VidetteMakes/ValpoFilamentRecycler09/BOM/Datasheets/BCZAMD Printer Heating Controller - Wiring.png

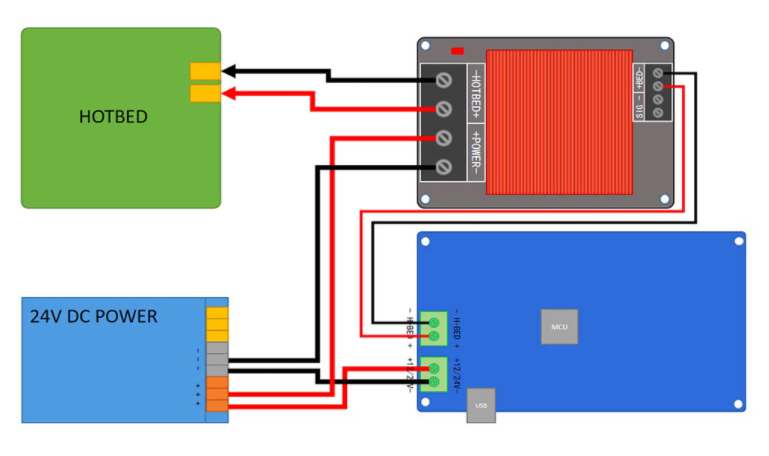
BOM/Datasheets/BCZAMD Printer Heating Controller - Wiring.png
