VidetteMakes/ValpoFilamentRecycler09/BOM/Datasheets/BCZAMD Printer Heating Controller.png

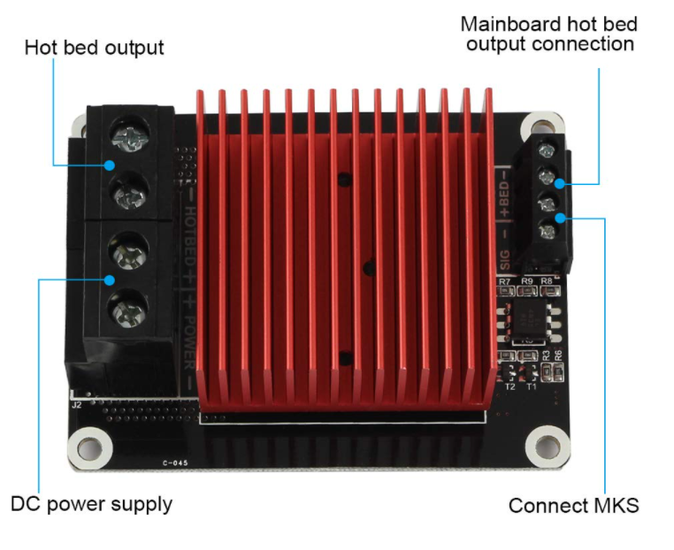
BOM/Datasheets/BCZAMD Printer Heating Controller.png
