VidetteMakes/ValpoFilamentRecycler09/README.md

# ValpoFilamentRecycler09

 Valpo Filament Senior Design Project

Check out the documentation folder for more information.
