VidetteMakes/ValpoFilamentRecycler09/PCB/Spooler Motor Driver/Spooler Motor Driver Schematic.pdf

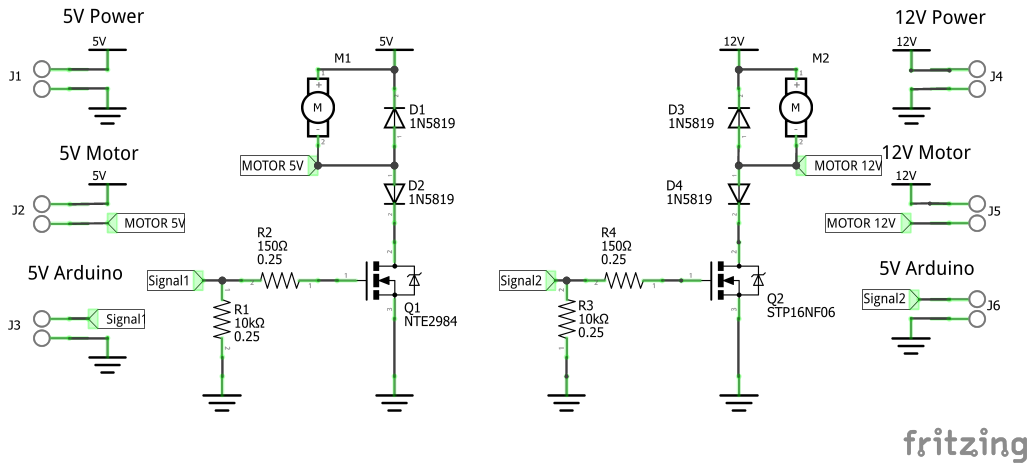
[picture p78: page 1]
