VidetteMakes/ValpoFilamentRecycler09/PCB/Spooler Motor Driver/Spooler Motor Driver.png

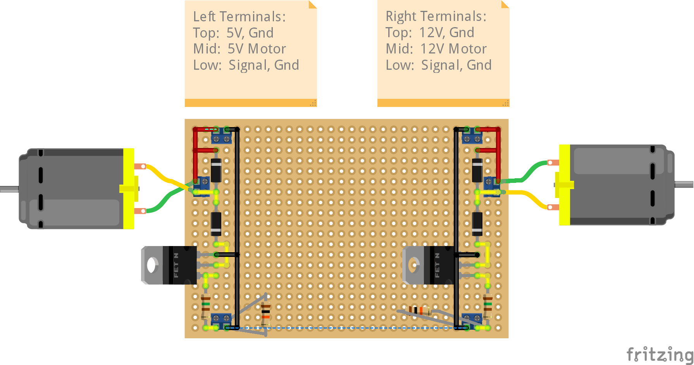
PCB/Spooler Motor Driver/Spooler Motor Driver.png
