VidetteMakes/ValpoFilamentRecycler09/BOM/BOM.xlsx

Sheet: Extruder
Part | Description | Preference | Supplier | Supplier Part Number | Manufactuer | Manufacturer Part Number | Quantity | Unit Price | Total Price
Frame | Custom welded frame and barrel holder | Sole Source |  |  | C2 Fab LLC |  | 1 |  | $0.00
Nozzle | 6061-T6511 Aluminum Square, 2.5" x 2.5" | Primary | MetalsDepot | SQ3212 | MetalsDepot |  | 1 | $5.78 | $5.78
Barrel/Screw | Precious Plastic Single Screw and Barrel | Sole Source | RobotDigg | PP-ES588L | Precious Plastics |  | 1 | $120.00 | $120.00
Barrel Flange | 304 Stainless Steel, Flat, 1/4" X 3-1/2" | Primary | MetalsDepot | F514312 | MetalsDepot |  | 1 | $5.84 | $5.84
Hopper Wall | Aluminum Plate 0.190 (3/16) thick 1' x 1' | Primary | Metals Depot | P3316 | Metals Depot |  | 1 | $29.38 | $29.38
Hopper Seal | Orange Rubber | Primary |  |  |  |  | 1 |  | $0.00
Hopper Lid | 304 Stainless Steel Wire Cloth, 3 x 3 Mesh Size, 0.27" Opening Size | Primary | Mcmaster | 85385T22 |  |  | 1 | $15.10 | $15.10
Gearbox Machine Key | Machine Key, 1018-1045 Steel, 1/4" x 1/4", 1-1/4" Long, Oversized | Primary | McMaster | 98870A405 |  |  | 1 | $8.34 | $8.34
Coupler Hub | High Torque Set Screw Flexible Shaft Coupling - Stainless Steel Hub | Primary | McMaster | 3565N1 |  |  | 1 | $48.24 | $48.24
Coupler Spider | High Torque Set Screw Flexible Shaft Coupling - Medium Split Spider | Primary | McMaster | 3565N43 |  |  | 1 | $16.18 | $16.18
Coupler Cover | 303 Stainless Steel Spider Cover for 2in Hub | Primary | McMaster | 3565N61 |  |  | 1 | $27.80 | $27.80
Insulation | Steam-Resistant High-Temperature Fiberglass Insulation, Tube, 1-1/2" Thick Wall, 1-7/8" ID, 3 Feet Long | Primary | McMaster | 5556K45 |  |  | 1 | $15.20 | $15.20
Tape | High-Strength Fiberglass Electrical Tape, Silicone Adhesive, 1/2" Wide, 54 Feet Long | Primary | McMaster | 7574A11 |  |  | 1 | $12.64 | $12.64
Barrel Heater | High-Temperature Heater for Pipes and Tubes, 120" Long with Wire Leads | Primary | McMaster | 3641K27 |  |  | 1 | $85.02 | $85.02
Nozzle Heater | Tatoko 8 x 40mm 100W Cartridge Heater 3 pieces | Primary | Amazon |  | Tatoko |  | 1 | $12.99 | $12.99
Nozzle Thermocouple | E3D Thermocouple | Primary | Amazon |  | E3D |  | 1 | $12.49 | $12.49
Electronics Enclosure | Indoor Enclosure with Hinged Cover and Knockouts, 12" x 12" x 6" | Primary | McMaster | 75065K68 | Hoffman Enclosures | AHE12X12X6 | 1 | $53.76 | $53.76
Motor | DC Permanent Magnet Motor, 1/3 Horsepower | Primary | Grainger | 48ZG52 | Leeson | 108050 | 1 | $372.00 | $372.00
Barrel Thermocouple | General purpose type K thermocouple with #6 spade terminals | Primary | Dwyer | 122095-01 | Dwyer | 122095-01 | 2 | $31.85 | $63.70
Temperature Controller | Series 16B 1/16 Din Tempearture Controller, voltage pulse and relay output, low voltage | Primary | Dwyer | 16B-23-LV | Dwyer | 16B-23-LV | 2 | $102.00 | $204.00
Solid State Relay | Solid State Relay SPST-NO 15A 75-250V | Primary | DigiKey | 255-2977-ND | Panasonic | AQA211VL | 2 | $26.12 | $52.24
Thermocouple Plug | Thermocouple Connector, Miniature Flat Pin, Type K, Plug | Primary | Automation Direct |  | ProSense | THMK-MP | 2 | $3.50 | $7.00
Thermocouple Plug | Thermocouple Connector, Miniature Flat Pin, Type K, Plug | Alternate | Newark | 30AC8456 | Omega | SMPW-K-M | 2 | $2.43
Thermocouple Receptacle | Thermocouple Connector, Miniature Flat Pin, Panel Jack, Round, Type K, Socket | Primary | Automation Direct |  | ProSense | THMK-MPJ | 2 | $6.00 | $12.00
Thermocouple Receptacle | Thermocouple Connector, Miniature Flat Pin, Panel Jack, Round, Type K, Socket | Alternate | Newark | 31AC5650 | Omega | RMJ-K-R | 2 | $2.51
Heater Receptacle | Circular Power Connector, Housing, 4 Position, Plug, Socket | Primary |  |  | TE Connectivity | 206060-1 | 2 | $7.33 | $14.66
Heater Crimp Socket | Crimp Power Contacts, Gold, 18 – 16AWG Wire Size | Primary |  |  | TE Connectivity | 66101-3 | 8 | $1.63 | $13.04
Heater Plug | Circular Power Connectors, Housing, 4 Position, Receptacle, Pin | Primary |  |  | TE Connectivity | 206061-1 | 2 | $5.73 | $11.46
Heater Crimp Pin | Crimp Power Contacts, Gold, 18 – 16AWG Wire Size, 13A Max Current | Primary |  |  | TE Connectivity | 66099-3 | 8 | $1.57 | $12.56
Motor Connector | Anderson Power Products Connector Kit, 600V, 10-12GA | Primary | Waytekwire | 37769 | Anderson Power | 5915-BK & 992G1-BK | 2 | $5.13 | $10.26
Gearbox | 881 Series Parallel Shaft Reducer, 143:1 Ratio, 12 RPM output @ 1725 RPM input | Primary |  |  | Bison Gear | 060-881-2143 | 1 | $808.75 | $808.75
24V Power Supply | AC/DC Converter, 24V, 25A | Primary | Digikey | 1866-4480-ND | Mean Well USA | SE-600-24 | 1 | $92.94 | $92.94
12V Power Supply | DC/DC Converter, 24V input, 12V, 5A output | Primary |  |  | TOBSUN | EA60-12V | 1 | $12.98 | $12.98
Motor Driver | Pololu G2 High-Power Motor Driver 18v17 | Primary | Pololu | 2991 | Pololu | 2991 | 1 | $29.95 | $29.95
Motor Driver, Resistor | 33k Ohm resistor (for Pololu Motor Driver; sets current limit) | Primary | Digikey | CF14JT33K0CT-ND | Stackpole Electronics Inc | CF14JT33K0 | 1 | $0.10 | $0.10
Motor Driver, Capacitor | Electrolytic Capacitor, 330uF, 35V, Radial (for Pololu Motor Driver) | Primary | Pololu | 882 |  |  | 1 | $0.49 | $0.49
Motor Driver, Capacitor | Electrolytic Capacitor, 470µF 50V, Radial (for Pololu Motor Driver) | Alternate | Digikey | 399-18277-1-ND | KEMET | ESK477M050AH4EA | 1 | $0.70
Motor Driver | DC Speed Control, Chassis, 0 to 48V DC Voltage Output, 20 A Max. Amps | Alternate | Grainger | 38EG41 | Dart Controls | 65E20C | 1 | $368.00
Power Connector | IEC-C14 Power Connector, Switch, Fuse | Primary | Digikey | 486-1278-ND | Schurter | DD11.0113.1111 | 1 | $11.27 | $11.27
Power Connector Fuse Drawer | IEC-C14 Fuse Drawer | Primary | Digikey | 486-2114-ND | Schurter | 4301.1409 | 1 | $4.70 | $4.70
Power Connector Fuse | 5x20 mm Fuse, 10A | Primary | Digikey | 486-1226-ND | Schurter | 34.3127 | 1 | $0.44 | $0.44
Power Cord | Power Cord, Black, IEC 320-C14 To IEC 320-C13, 6.00' (1.83m) | Primary | Digikey | 2830-PWRC13C1406FBLK-ND | Unirise USA | PWRC13C1406FBLK | 1 | $4.99 | $4.99
Power Cord | Power Cord, Black, IEC 320-C14 To IEC 320-C13, 6.00' (1.83m) | Alternate | Adafruit | 3311 |  |  | 1 | $5.95
 | Standard LCD 16x2 + extras - white on blue | Primary | DigiKey | 1528-1502-ND | Adafruit | 181 | 2 | $9.95 | $19.90
 | I2C / SPI Character LCD Backpack | Primary | DigiKey | 1528-1446-ND | Adafruit | 292 | 2 | $9.95 | $19.90
 |  |  |  | Total |  |  |  |  | $2248.09
 | REMOVE
 | Emergency Stop Enclosed Push-Button Switch |  | McMaster | 6785K21 |  |  | 1 | 43.8
 | Emergency Stop Button |  | Digikey | 360-FF0126BBCAEA01-ND |  |  | 1 | 43.82
 | DC/DC Converter, 24V input, 5V,1.2A output |  | Digikey | 102-4574-ND | CUI Inc | PQDE6W-Q24-S5-T | 1 | 20.25
 | REPLACE HARDWIRED CORD WITH C20
 | Power Cord, 12AWG, NEMA 5-20P, 6.56 foot |  | Digikey | 1939-1017-ND | GlobTek Inc | 3201776F6000(R) | 1 | 19.54
 | EVALUATE AS ALTERNATE:
 | Helical Gearbox, 40:1 Ratio, 44 RPM output @ 1750 RPM input |  | Automation Direct | HGR-37-040-A | Iron Horse | HGR-37-040-A | 1 | 410
 | CONSIDER (IF REVERSING SWITCH IS NEEDED):
 | 07-2-2-17 KISSLING Series 07, Toggle Switches, Double Pole - Double Throw Configuration (Pole-Throw), M12 x .75, Sealed Toggle Switch, Cu, Silver Tin Oxide |  |  |  | TE Connectivity | K1002983 | 1 | 19.32
 | Rocker Switch, Non Illuminated, SPDT, (On)-Off-On, Black, Panel Mount, 15 A |  | Newark | 97W6256 | Eaton | NGR10061BG00N | 1 | 14.65

Sheet: Spooler
Part | Description | Preference | Supplier | Supplier Part Number | Manufactuer | Manufacturer Part Number | Quantity | Unit Price | Total Price
Frame | T-Slotted Framing Rails, Silver, 4-1/2" High x 1-1/2" Wide, Solid | Primary | McMaster | 47065T521 | McMaster |  | 1 | $96.10 | $96.10
Fan | Fan Blower 5VDC, 45mm L x 45mm H, 3.5 CFM (0.098m³/min), 3 Wire Leads |  | Digikey | 603-2120-ND | Delta Electronics | BFB04505HHA-CF00 | 2 | 13.27 | 26.54
Diameter Sensor | Digital Indicator 0-0.5"/12.7mm Resolution 0.00005" |  | Amazon |  | Clockwise Tools | DITR-0055 | 1 | $44.45 | $44.45
Bearing | 6mm Bore Bearing with 19mm White Plastic Square Tire 6x19x6mm |  | Amazon | WT0619 | VXB | 6MMX19MMTIRE-WHITE | 2 | $8.09 | $16.18
USB Cable | USB 2.0 Cable, A Male to Micro B Male, Shielded, 6.56' (2.00m) |  | DigiKey | AE10342-ND | Assmann WSW Components | AK67421-2 | 1 | $5.04 | $5.04
Photo Interrupter | T-Slot Photo Interrupter with 1 Meter Cable |  |  |  | Adafruit | 3985 | 1 | $3.95 | $3.95
Load Cell | Strain Gauge Load Cell, 4 Wires, 1Kg |  | Digikey | 1528-4540-ND | Adafruit | 4540 | 4 | $3.95 | $15.80
Spooler Motor | 942DLN Series Gearbox & DC Motor, 12V |  |  |  | MFA Como Drills | 942DLN | 1
MOSFET, Fans | N-Channel Power MOSFET, 60V, 17A, Through Hole, TO-220 (for 5V DC motors) |  | DigiKey | 2368-NTE2984-ND | NTE Electronics | NTE2984 | 7 | $2.75 | $19.25
MOSFET, Spooler | N-Channel Power MOSFET, 60V, 16A, Through Hole, TO-220 (for 12V DC motors) |  | Digikey | 497-2766-5-ND | ST | STP16NF06 |  |  | $0.00
Arduino Uno | Arduino Uno R3 |  | Digikey | 1050-1024-ND | Arduino | A000066 | 1 | $22.00 | $22.00
USB-A Connector | USB-A Connector, Through Hole, Right Angle |  | DigiKey | ED2989-ND | On Shore Technology | USB-A1HSW6 | 1 | $0.48 | $0.48
Headers, Male | Connector Header, Through Hole, Vertical, 0.100" (2.54mm), 40 position |  | DigiKey | S1012EC-40-ND | Sullins Connector Solutions | PREC040SAAN-RC | 5 | $0.51 | $2.55
Connector, 2 position | Connector Header, Through Hole, Vertical, 0.098" (2.50mm), 2 position |  | DigiKey | 455-2247-ND | JST Sales America | B2B-XH-A(LF)(SN) | 7 | $0.15 | $1.05
Plug, 2 position | Connector Housing, Free Hanging, 0.098" (2.50mm), 2 position |  | DigiKey | 455-2266-ND | JST Sales America | XHP-2 | 7 | $0.10 | $0.70
Connector, 3 position | Connector Header, Through Hole, 0.098" (2.50mm), 3 position |  | DigiKey | 455-2248-ND | JST Sales America | B3B-XH-A(LF)(SN) | 4 | $0.19 | $0.76
Plug, 3 position | Connector Housing, Free Hanging, 0.098" (2.50mm), 3 position |  | DigiKey | 455-2219-ND | JST Sales America | XHP-3 | 4 | $0.10 | $0.40
Connector, 4 position | Connector Header, Through Hole, 0.098" (2.50mm), 4 position |  | DigiKey | 455-2249-ND | JST Sales America | B4B-XH-A(LF)(SN) | 4 | $0.21 | $0.84
Plug, 4 position | Connector Housing, Free Hanging, 0.098" (2.50mm), 4 position |  | DigiKey | 455-2267-ND | JST Sales America | XHP-4 | 4 | $0.10 | $0.40
Connector, 5 position | Connector Header, Through Hole, 0.098" (2.50mm), 5 position |  | DigiKey | 455-2270-ND | JST Sales America | B5B-XH-A(LF)(SN) | 2 | $0.25 | $0.50
Plug, 6 position | Connector Housing, Free Hanging, 0.098" (2.50mm), 6 position |  | DigiKey | 455-2218-ND | JST Sales America | XHP-6 | 2 | $0.14 | $0.28
Wire | TUOFENG 22AWG PVC Electrical Wire Kit |  | Amazon |  | Tuofeng |  | 1 | 14.99 | $14.99
Power Supply | DC Power Wall Wort, 12V, 2A |  |  |  |  |  | 1 |  | $0.00
 |  |  |  | Total |  |  |  |  | $272.26
 | REPLACE 5V FAN WITH 12V FAN?
OBSOLETE: | Fan Blower 12VDC Square/Rounded - 60mm L x 60mm H Vapo-Bearing™ 5.7 CFM (0.160m³/min) 2 Wire Leads |  | Digikey | 259-1752-ND | Sunon Fans | MF60151V1-B00U-A99 | 2 | 6.97
 | EVALUATE AS ALTERNATE:
 | Compression Load Cell |  | Digikey | 223-FX292X-100A-0010-L-ND | TE Connectivity Measurement Specialties | FX292X-100A-0010-L | 3 | 22.51
 | Arduino MKR 485 Shield |  |  |  | Arduino | ASX00004 | 1 | 32.1
 | Brushed DC Motor Gearmotor 100 RPM 8W 24VDC (can run at 12V, but recommend 12V; see similar by same manufacturer) |  | Digikey | 2183-4685-ND | Pololu | 4685 | 1 | 24.95
 | ORIGINALLY PART OF TENSIONER; OBSOLETE
 | Continuous Rotation DC Motor Servo motor, RC Hobby, 4.8 - 6VDC |  | Digikey | 2589-33485S-ND | Hitec | 33485S | 2 | 17.39
 | EXTRA PARTS
 | Linear Optical Array Sensor I2C, SPI Output |  | Digikey | MLX75306KXZ-BAA-000-RETR-ND | Melexis Technologies NV | MLX75306KXZ-BAA-000-RE | 1 | 13.88
 | Screw Terminal Block, Side-Mounted, Gray ABS Plastic, 4 Circuits |  | McMaster | 1041N9 |  |  | 1 | 13.77

Sheet: Controller
Part | Description | Preference | Supplier | Supplier Part Number | Manufactuer | Manufacturer Part Number | Quantity | Unit Price | Total Price
 | Standard LCD 16x2 + extras - white on blue | Primary | DigiKey | 1528-1502-ND | Adafruit | 181 | 2 | $9.95 | $19.90
 | I2C / SPI Character LCD Backpack | Primary | DigiKey | 1528-1446-ND | Adafruit | 292 | 2 | $9.95 | $19.90
 | Pushbutton, SPST, Normally Open, 0.1A, 32V |  | Digikey | 401-1973-ND | C&K | D6R10 F1 LFS | 5 | $1.13 | $5.65
 | Potentiometer, 5k Ohm, Through Hole, 0.05W |  | DigiKey | 987-1294-ND | TT Electronics | P120PK-F17BR5K | 4 | $0.63 | $2.52
 | SparkFun Transceiver Breakout - RS-485 | Primary |  |  | SparkFun | BOB-10124 | 1 | $10.95 | $10.95
DC/DC Converter | Linear Regulator DC DC Converter, 8V - 28V Input, 5V, 1A Output | Primary | DigiKey | 945-2201-ND | Recom Power | R-78E5.0-1.0 | 1 | $2.52 | $2.52
Total |  |  |  |  |  |  |  |  | $61.44
 | NOT PRESENT:
 | Potentiometer, 10k Ohm Logarithmic, Panel Mount, 0.1W, Solder Lug |  | Digikey | 987-P165K200PNN20MN103-ND | TT Electronics/BI | P165K200PNN20MN103 | 1 | 4.13
 | Digital Potentiometer, 10k Ohm, 100 Taps, 8-PDIP |  | DigiKey | DS1804-010+-ND | Maxim Integreated | DS1804-010+ | 1 | 4.3
 | REMOVE:
 | Arduino Mega 2560 |  | Digikey | 1050-1018-ND | Arduino | A000067 | 1 | 38.5
 | SparkFun Logic Level Converter - Bi-Directional |  |  |  | SparkFun | BOB-12009 | 1 | 2.95
 | RJ45 (Ethernet) Jack, Right Angle, Shielded |  | DigiKey | AE10387-ND | Assmann WSW Components | A-2004-2-4-LPS-N-R | 2 | 1.2
 | RJ45 (Ethernet) Cable, Unshielded, 3.00' (914.4mm) |  | DigiKey | 367-1104-ND | Cinch Connectivity Solutions | 73-7791-3 | 1 | 2.56
