VidetteMakes/ValpoFilamentRecycler09/CAD/Coupler/couplerassembly.SLDASM

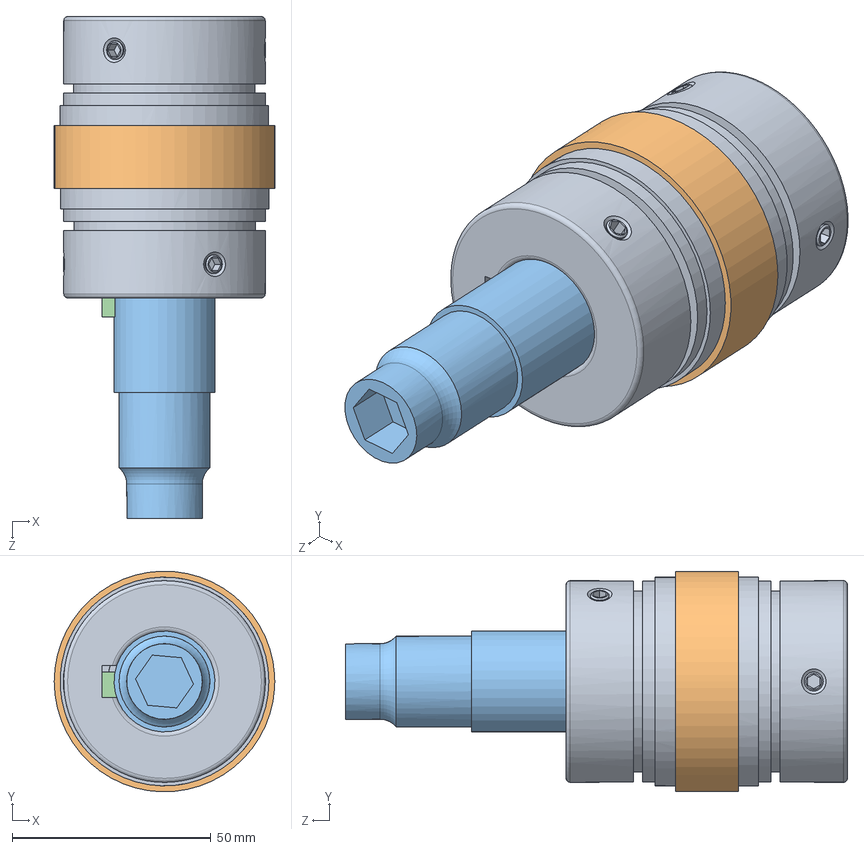
[picture p80: CAD file, 2021-05-10]
CAD/Coupler/couplerassembly.SLDASM
55.6 x 55.5 x 126.4 mm
CouplerPiece x 2
CouplerConnection
CouplerShaft
98870A405_STEEL MACHINE KEY
