VidetteMakes/ValpoFilamentRecycler09/CAD/Final AssemblyF.SLDASM

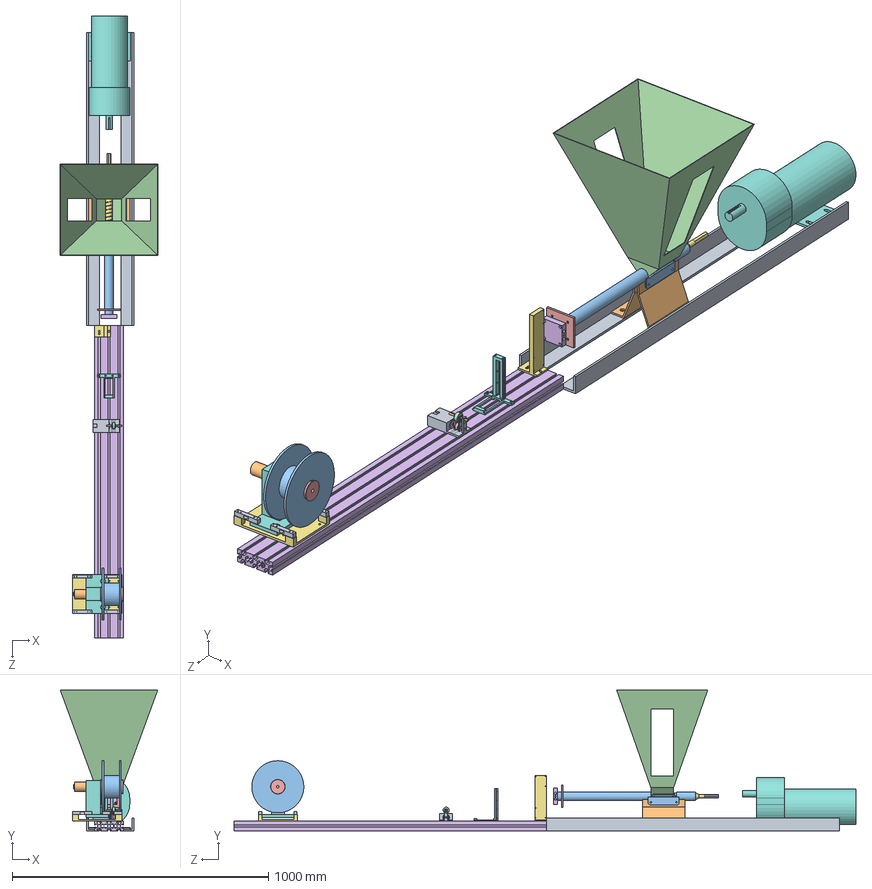
[picture p81: CAD file, 2021-05-10]
CAD/Final AssemblyF.SLDASM
381.0 x 550.1 x 2427.0 mm
Angle IronsF
Mounting x 2
Barrel1.3
Hopper
flange
nozzle cap
Screw
DCMotor
Roller Structure5
Axle4
Roller_AxelF
Roller3
RollerF
ServoF
BaseMountingPlateSpooler
TopPlateSpooler
StrainGauge x 4
Spooler servo
1kg_Spool
SpoolCrusher
SpoolCrusherEnd
Mounting body
Fan mount 2.0
SlackSensorGrande
