VidetteMakes/ValpoFilamentRecycler09/CAD/Extrusion Assembly/Extrusion Assembly.SLDASM

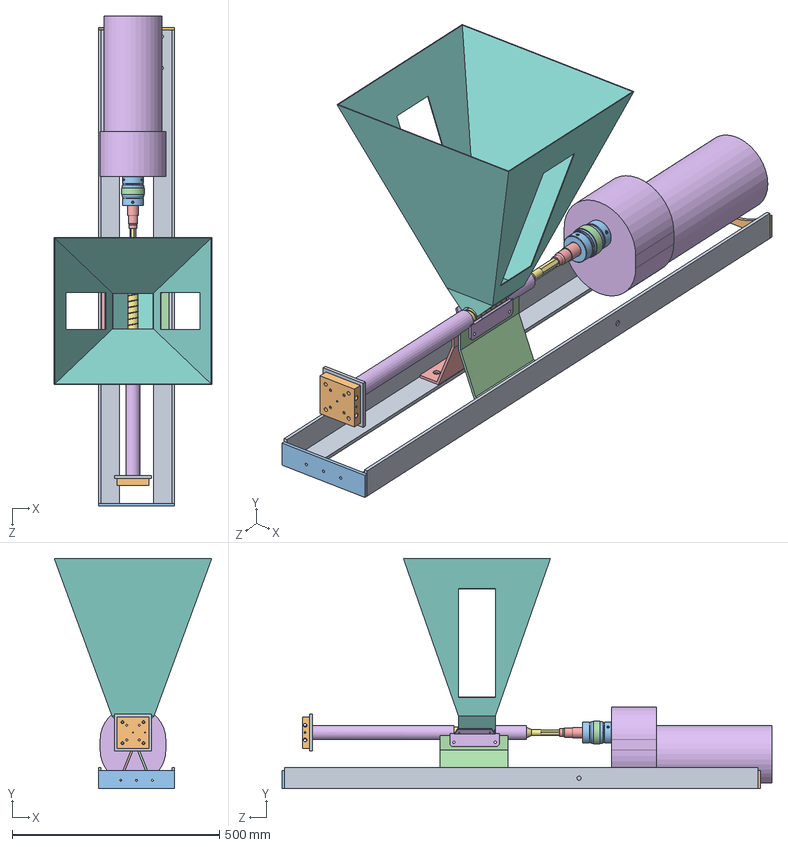
[picture p82: CAD file, 2021-05-10]
CAD/Extrusion Assembly/Extrusion Assembly.SLDASM
381.0 x 556.4 x 1183.4 mm
Angle IronsF
Back_plate
Front Plate
Mounting (1)
Mounting
Barrel1.3
Screw
Hopper
flange
Nozzle_3mm (1)
CouplerPiece x 2
CouplerConnection
CouplerShaft
DCMotor
