VidetteMakes/ValpoFilamentRecycler09/CAD/PCB Boxes/UI_BOX_ASSEM.SLDASM

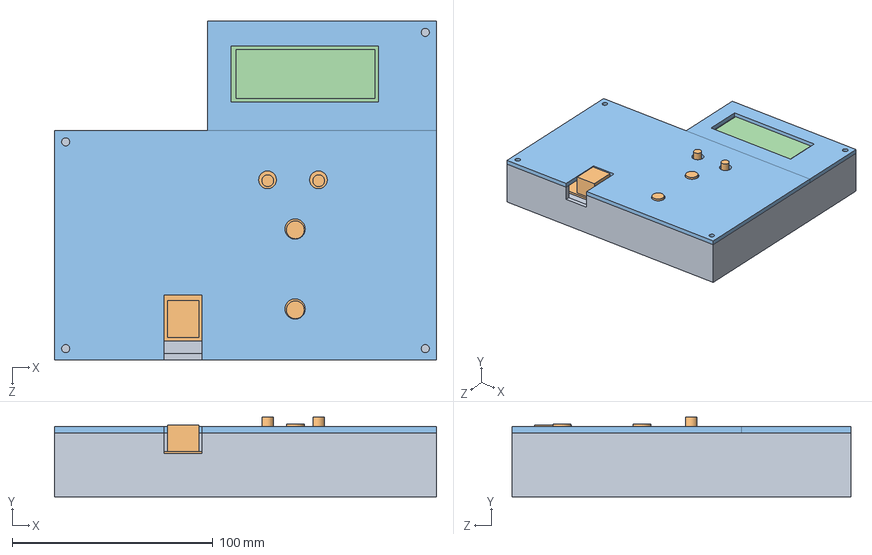
[picture p83: CAD file, 2021-05-10]
CAD/PCB Boxes/UI_BOX_ASSEM.SLDASM
190.5 x 39.7 x 168.9 mm
UI_Box
UI_PCB
UI_Box_Top
LCD
