VidetteMakes/ValpoFilamentRecycler09/CAD/Tensioner/Tensioner Assembly.SLDASM

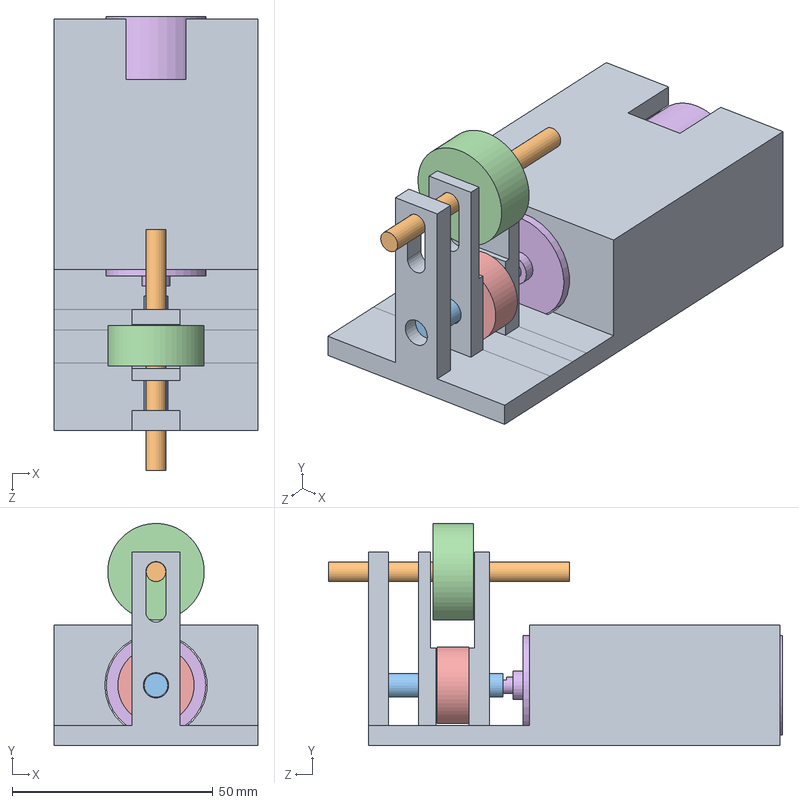
[picture p84: CAD file, 2021-05-10]
CAD/Tensioner/Tensioner Assembly.SLDASM
50.8 x 55.3 x 113.1 mm
Roller Structure5
Axle4
Roller_AxelF
Roller3
RollerF
ServoF
