VidetteMakes/ValpoFilamentRecycler09/CAD/Spooler/SpoolerAssem.SLDASM

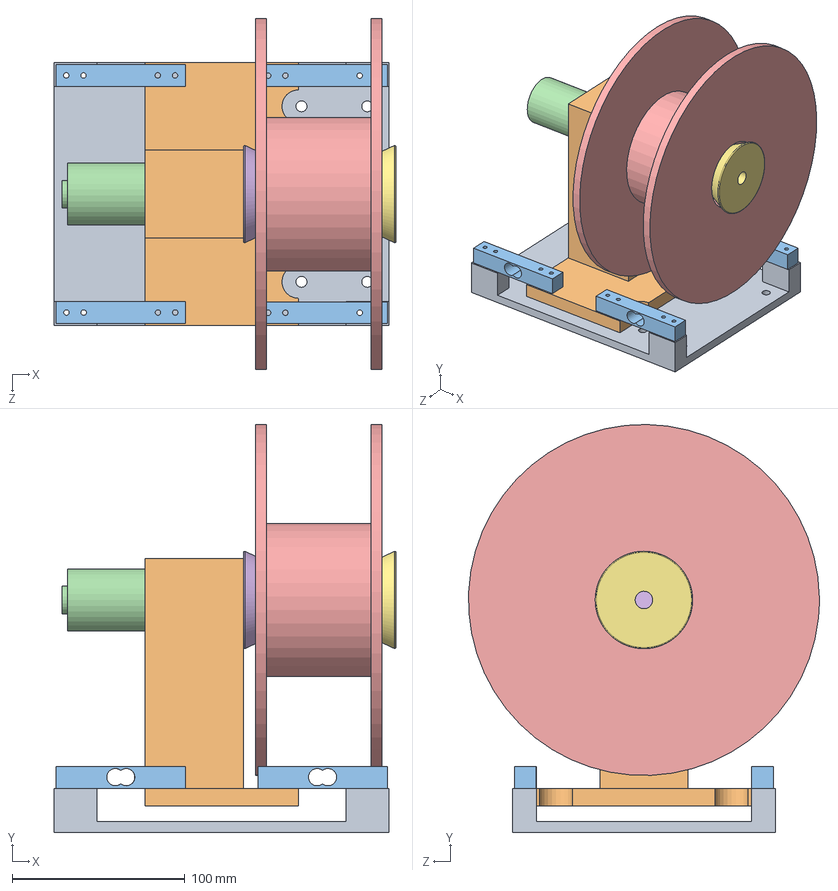
[picture p85: CAD file, 2021-05-10]
CAD/Spooler/SpoolerAssem.SLDASM
198.0 x 236.2 x 203.1 mm
BaseMountingPlateSpooler
TopPlateSpooler
StrainGauge x 4
Spooler servo
1kg_Spool
SpoolCrusher
SpoolCrusherEnd
