VidetteMakes/ValpoFilamentRecycler09/CAD/Extrusion Assembly/Base.SLDASM

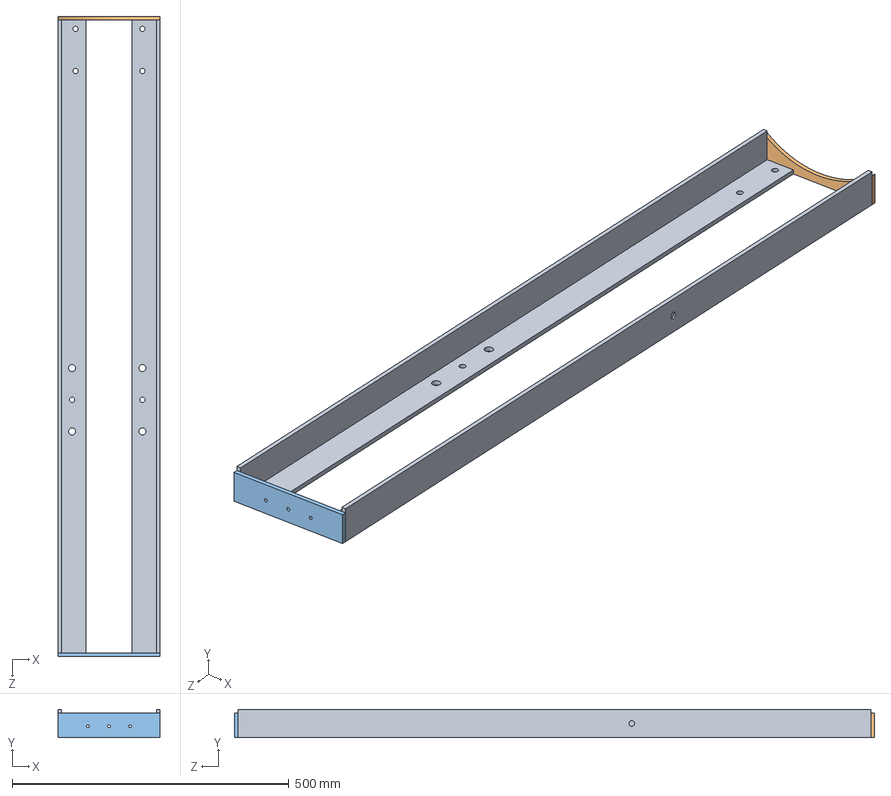
[picture p86: CAD file, 2021-05-10]
CAD/Extrusion Assembly/Base.SLDASM
184.1 x 50.8 x 1155.7 mm
Angle IronsF
Back_plate
Front Plate
