VidetteMakes/ValpoFilamentRecycler09/CAD/Extrusion Assembly/Barrel_Assembly.SLDASM

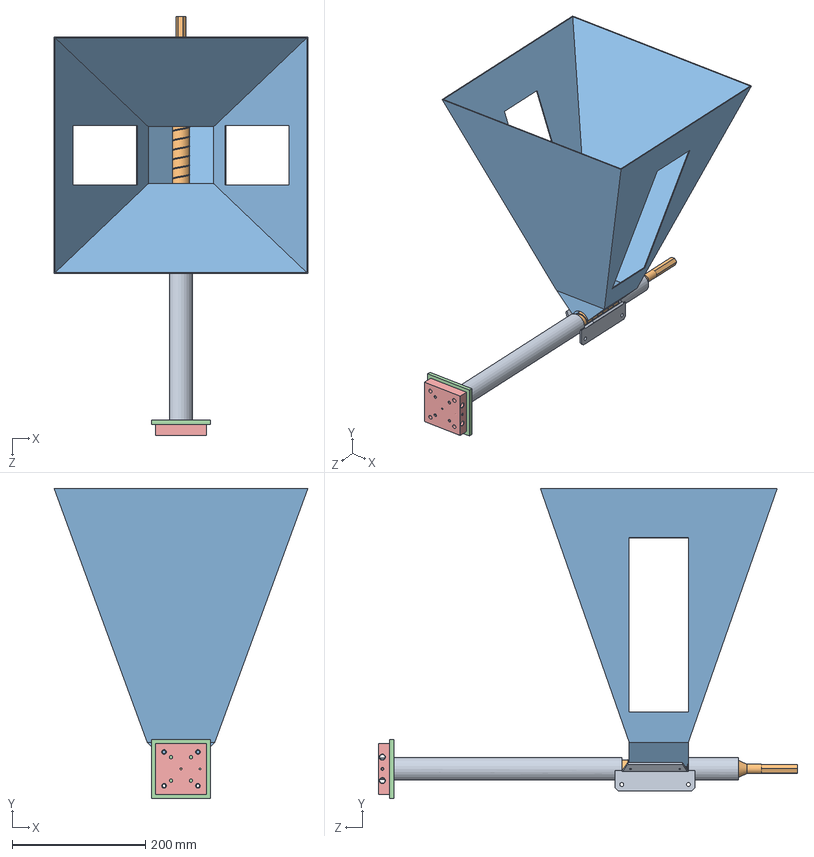
[picture p87: CAD file, 2021-05-10]
CAD/Extrusion Assembly/Barrel_Assembly.SLDASM
381.0 x 465.3 x 629.2 mm
Barrel1.3
Screw
Hopper
flange
Nozzle_3mm (1)
