VidetteMakes/ValpoFilamentRecycler09/CAD/.STL files/Tensioner_Platform.STL

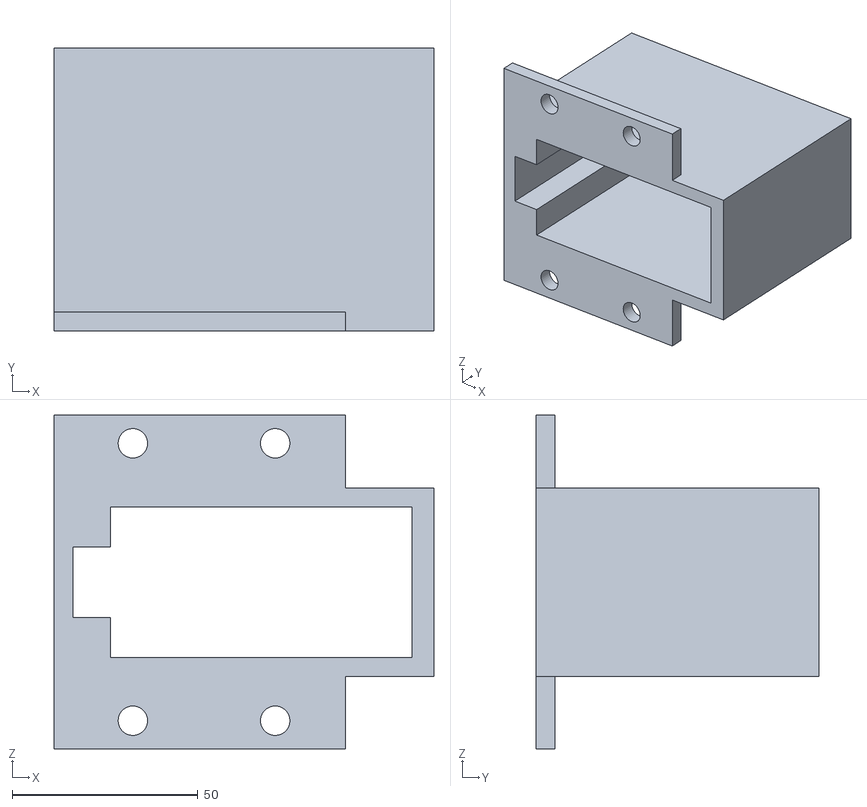
[picture p88: CAD file, 2021-05-10]
CAD/.STL files/Tensioner_Platform.STL
102.4 x 76.2 x 90.0
