VidetteMakes/ValpoFilamentRecycler09/CAD/Coupler/CouplerPiece.SLDPRT

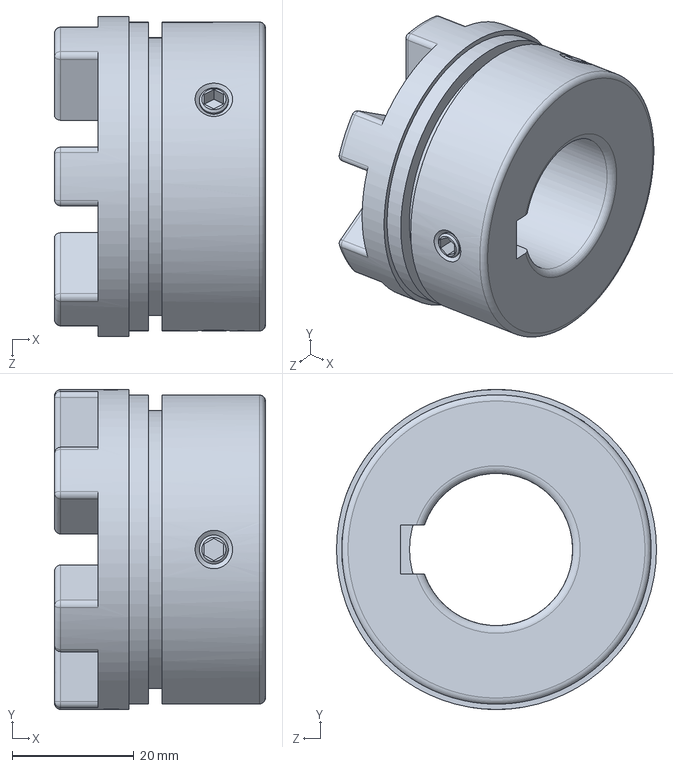
[picture p89: CAD file, 2021-05-10]
CAD/Coupler/CouplerPiece.SLDPRT
34.7 x 52.6 x 52.6 mm
