VidetteMakes/ValpoFilamentRecycler09/CAD/Dial Indicator Housing/FilamentMeasBackPlateV2.stp

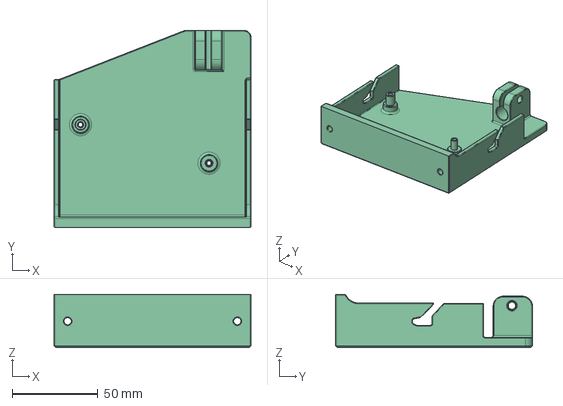
[picture p90: CAD file, 2021-07-17]
CAD/Dial Indicator Housing/FilamentMeasBackPlateV2.stp
115.0 x 115.0 x 31.0 mm
