VidetteMakes/ValpoFilamentRecycler09/CAD/Extrusion Assembly/CouplerConnection.SLDPRT

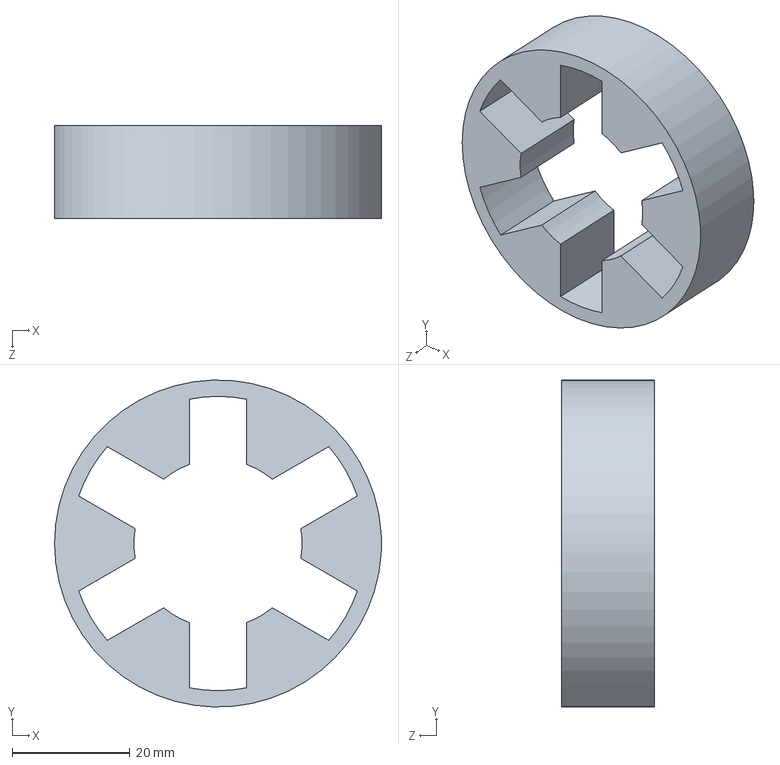
[picture p91: CAD file, 2021-05-10]
CAD/Extrusion Assembly/CouplerConnection.SLDPRT
55.6 x 55.5 x 15.9 mm
