VidetteMakes/ValpoFilamentRecycler09/CAD/Main components/DCMotor.SLDPRT

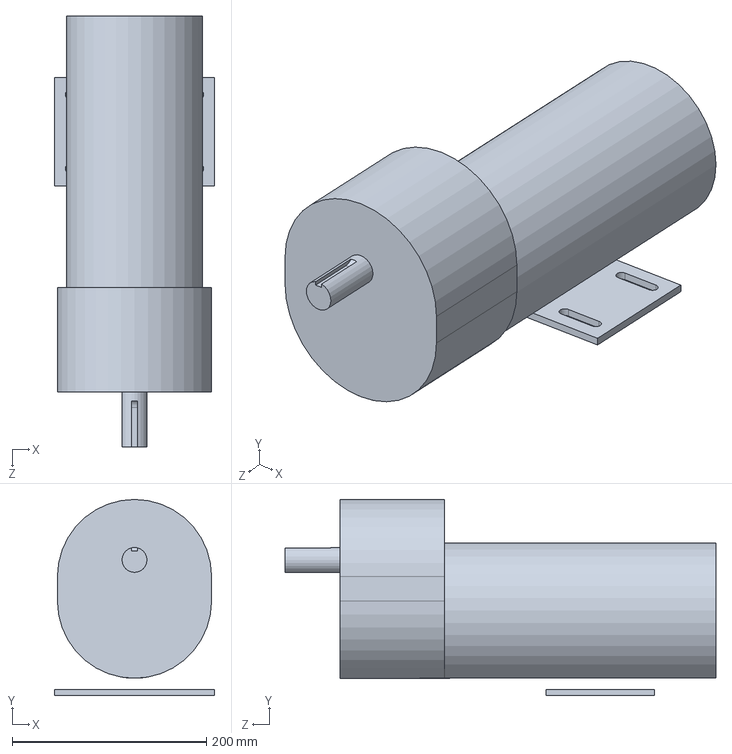
[picture p92: CAD file, 2021-05-10]
CAD/Main components/DCMotor.SLDPRT
165.1 x 202.0 x 443.8 mm
