VidetteMakes/ValpoFilamentRecycler09/CAD/PCB Boxes/UI_Box.SLDPRT

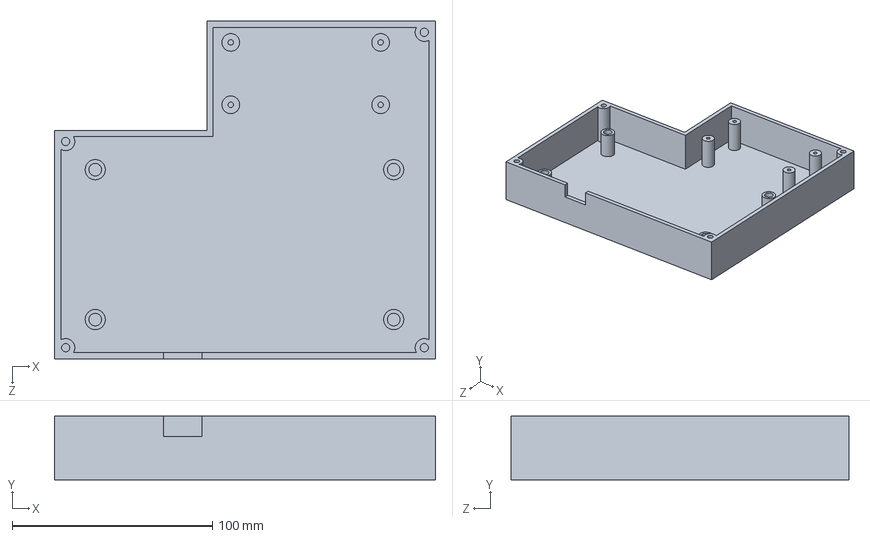
[picture p93: CAD file, 2021-05-10]
CAD/PCB Boxes/UI_Box.SLDPRT
190.5 x 31.8 x 168.9 mm
