VidetteMakes/ValpoFilamentRecycler09/CAD/ServoCap.SLDPRT

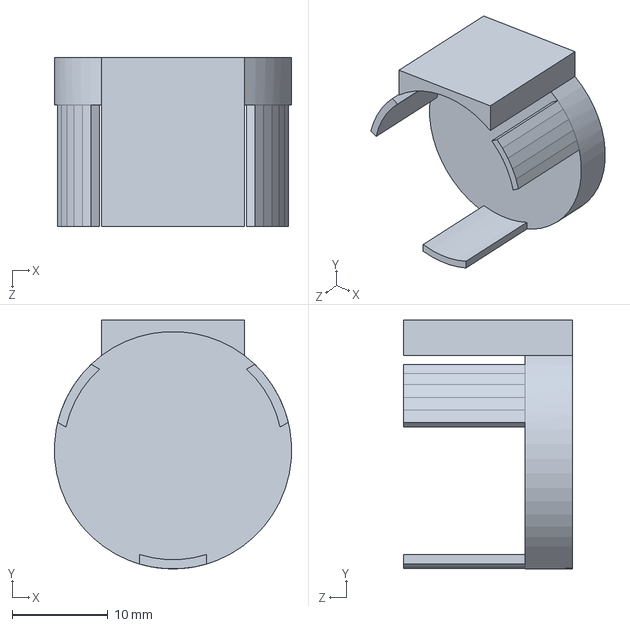
[picture p94: CAD file, 2021-05-10]
CAD/ServoCap.SLDPRT
24.8 x 26.0 x 17.7 mm
