VidetteMakes/ValpoFilamentRecycler09/CAD/Spooler/SpoolCrusher.SLDPRT

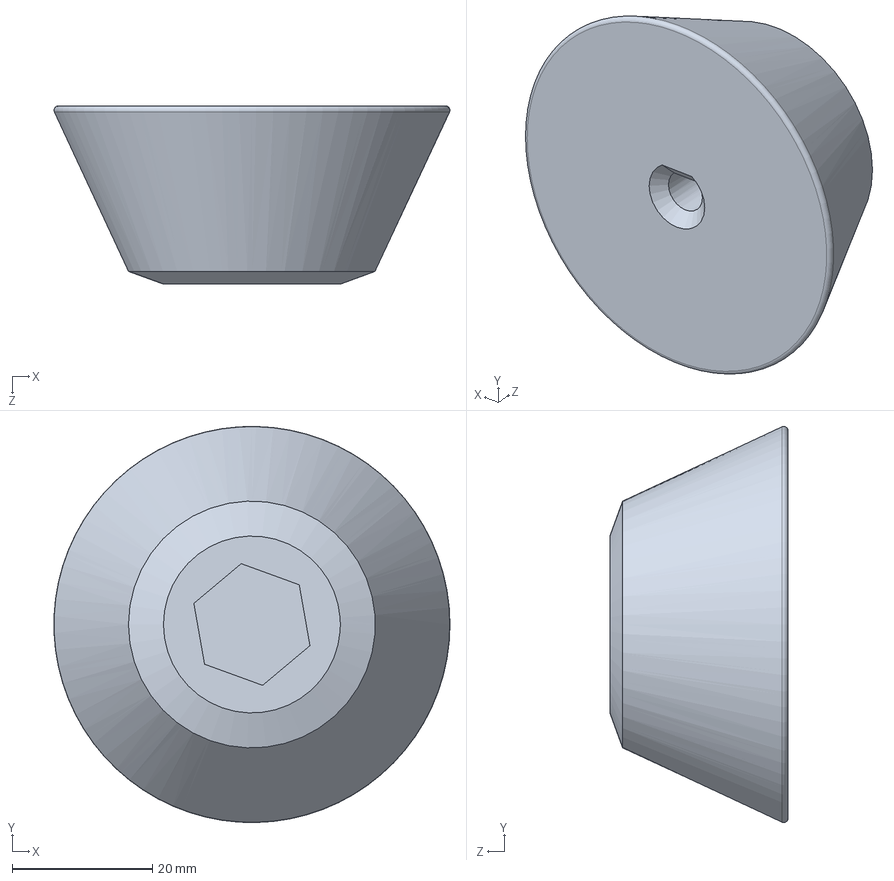
[picture p95: CAD file, 2021-05-10]
CAD/Spooler/SpoolCrusher.SLDPRT
56.4 x 56.4 x 25.4 mm
