VidetteMakes/ValpoFilamentRecycler09/CAD/Tensioner/Axle4.SLDPRT

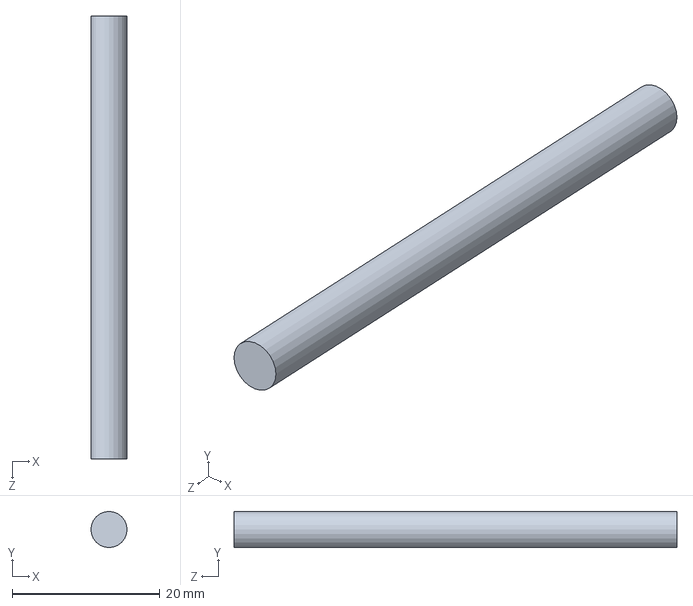
[picture p96: CAD file, 2021-05-10]
CAD/Tensioner/Axle4.SLDPRT
4.90 x 4.90 x 60.0 mm
