VidetteMakes/ValpoFilamentRecycler09/CAD/Triangular Mounting/Mounting.SLDPRT

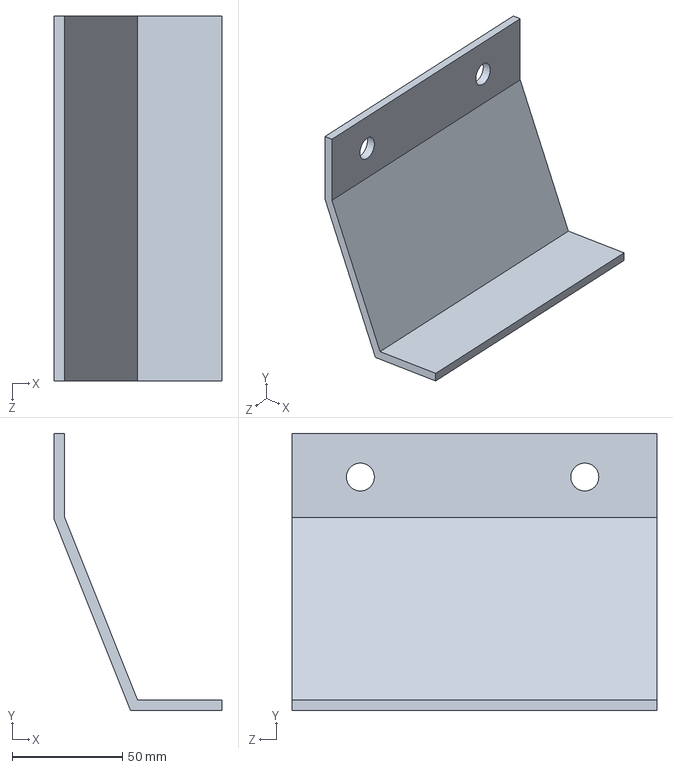
[picture p97: CAD file, 2021-05-10]
CAD/Triangular Mounting/Mounting.SLDPRT
75.9 x 125.4 x 165.1 mm
