VidetteMakes/ValpoFilamentRecycler09/CAD/.STL files/Fan mount 2.0 (1).STL

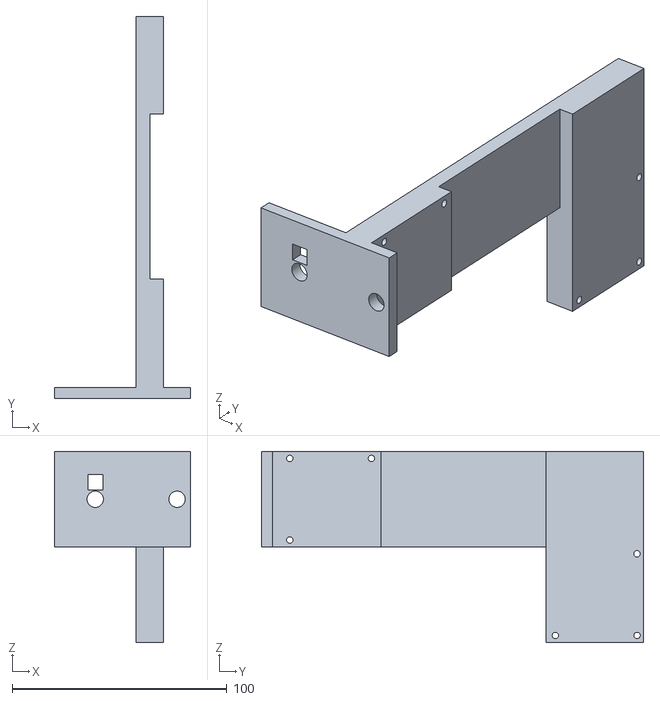
[picture p98: CAD file, 2021-05-10]
CAD/.STL files/Fan mount 2.0 (1).STL
63.5 x 177.8 x 88.9
