VidetteMakes/ValpoFilamentRecycler09/CAD/Dial Indicator Housing/FilamentMeasurementArrmOuterV3.stp

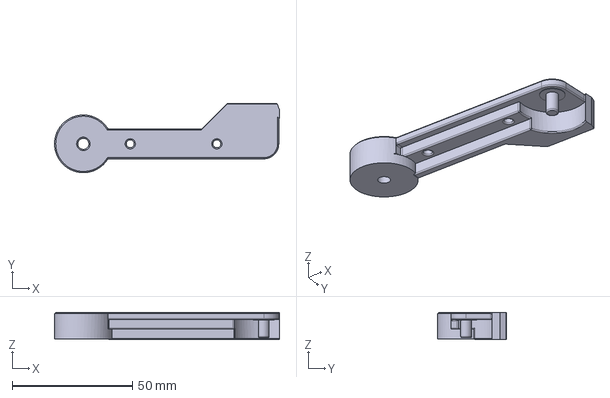
[picture p99: CAD file, 2021-07-17]
CAD/Dial Indicator Housing/FilamentMeasurementArrmOuterV3.stp
93.5 x 28.9 x 11.2 mm
