VidetteMakes/ValpoFilamentRecycler09/CAD/Extrusion Assembly/Barrel1.3.SLDPRT

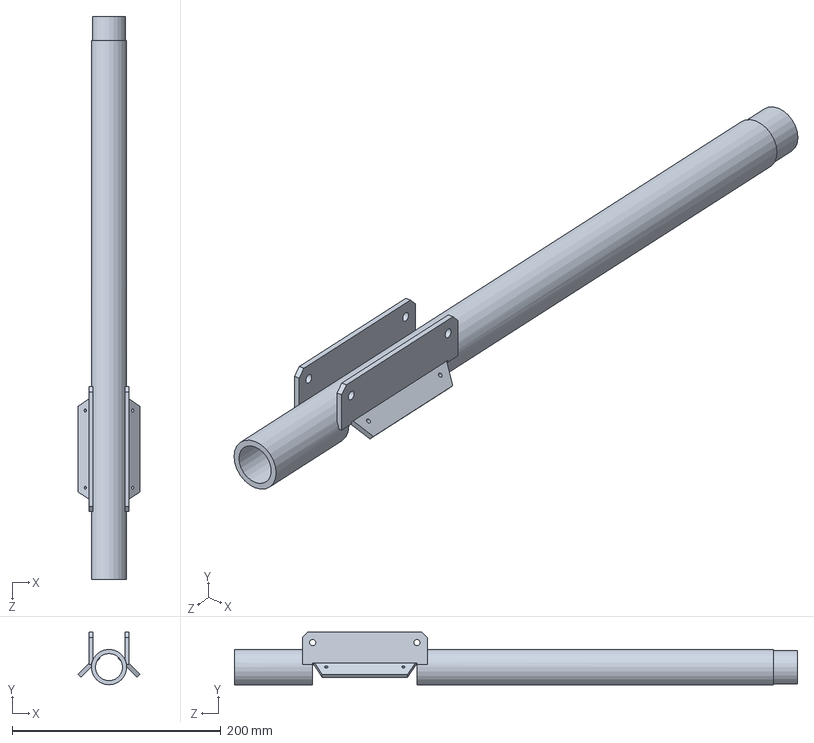
[picture p100: CAD file, 2021-05-10]
CAD/Extrusion Assembly/Barrel1.3.SLDPRT
59.6 x 50.5 x 540.0 mm
