VidetteMakes/ValpoFilamentRecycler09/CAD/PCB Boxes/Controller_lid.SLDPRT

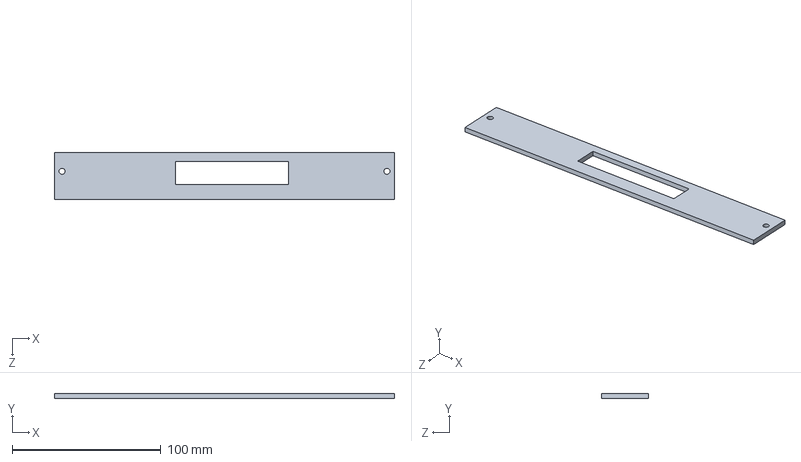
[picture p101: CAD file, 2021-05-10]
CAD/PCB Boxes/Controller_lid.SLDPRT
228.6 x 3.17 x 31.8 mm
