VidetteMakes/ValpoFilamentRecycler09/CAD/Spooler/1kg_Spool.SLDPRT

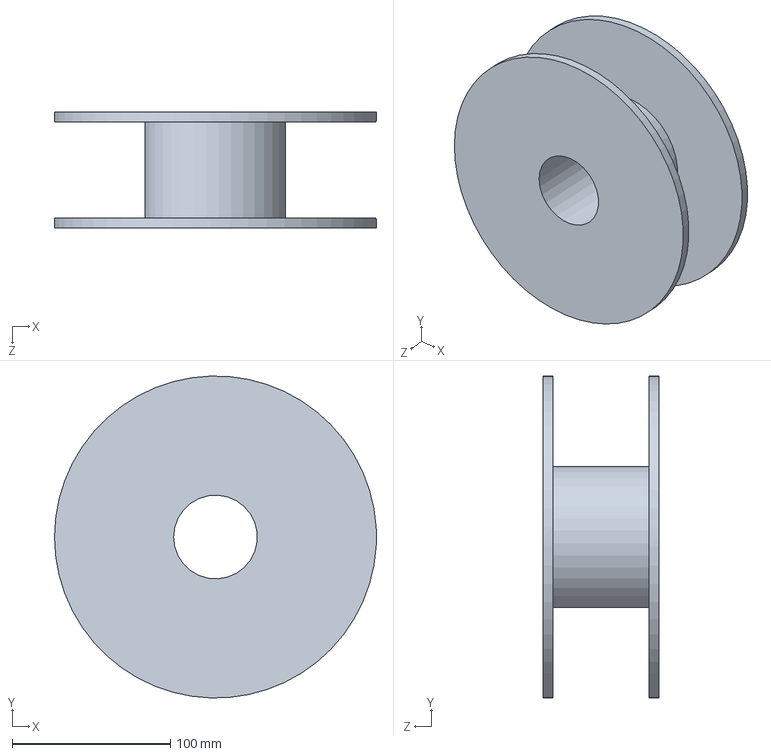
[picture p102: CAD file, 2021-05-10]
CAD/Spooler/1kg_Spool.SLDPRT
203.2 x 203.1 x 73.2 mm
