VidetteMakes/ValpoFilamentRecycler09/CAD/Tensioner/Roller Structure5.SLDPRT

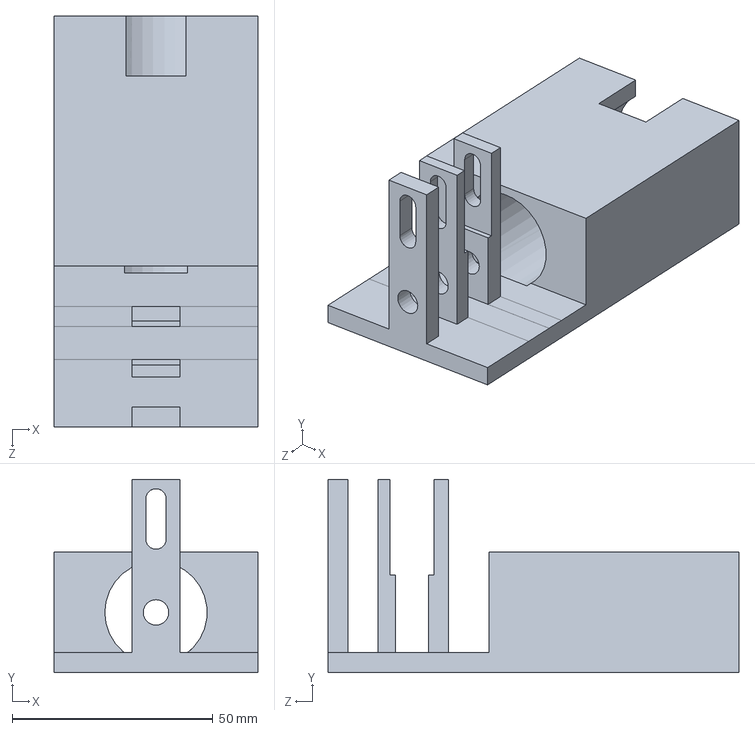
[picture p103: CAD file, 2021-05-10]
CAD/Tensioner/Roller Structure5.SLDPRT
50.8 x 48.1 x 102.4 mm
