VidetteMakes/ValpoFilamentRecycler09/CAD/Troubled components/nikki mods/RollerF.SLDPRT

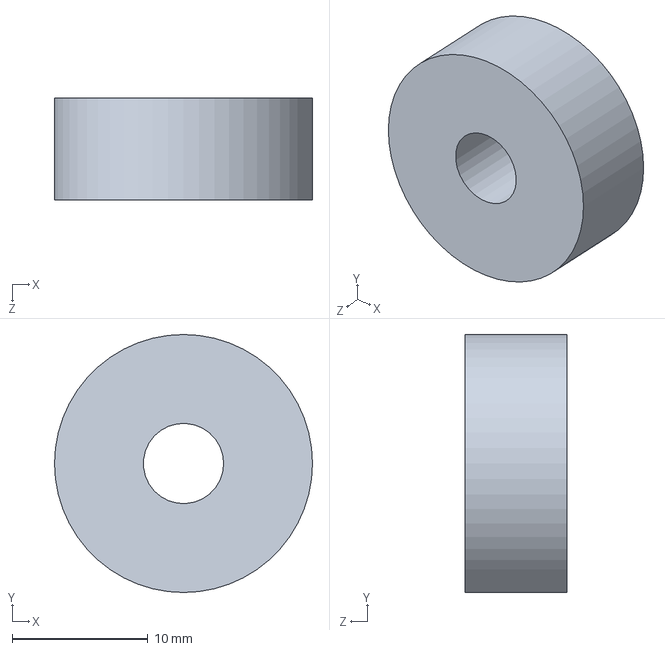
[picture p104: CAD file, 2021-05-10]
CAD/Troubled components/nikki mods/RollerF.SLDPRT
19.0 x 19.0 x 7.50 mm
