VidetteMakes/ValpoFilamentRecycler09/CAD/.STL files/SlackSensorGrande.STL

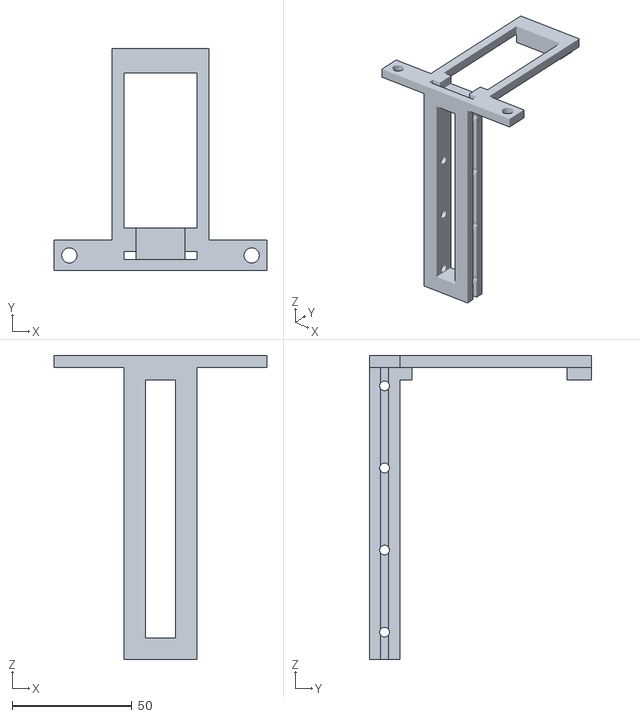
[picture p105: CAD file, 2021-05-10]
CAD/.STL files/SlackSensorGrande.STL
88.9 x 92.9 x 127.0
