VidetteMakes/ValpoFilamentRecycler09/CAD/Coupler/CouplerShaft.SLDPRT

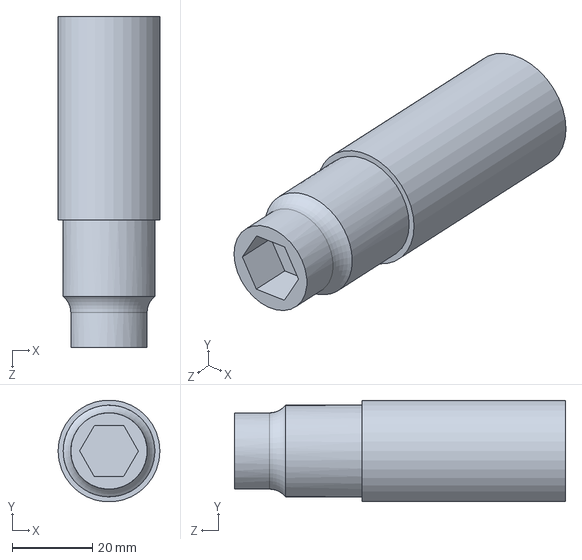
[picture p106: CAD file, 2021-05-10]
CAD/Coupler/CouplerShaft.SLDPRT
25.4 x 25.3 x 82.5 mm
