VidetteMakes/ValpoFilamentRecycler09/CAD/FilimentSupportBracket.SLDPRT

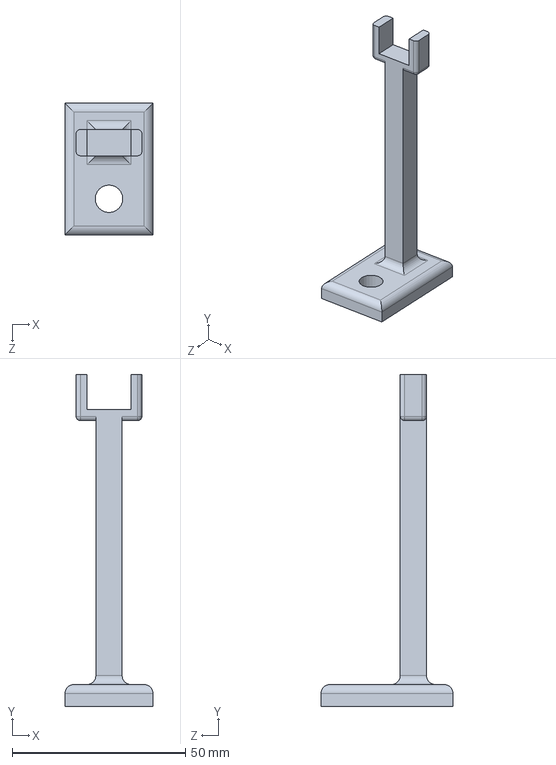
[picture p107: CAD file, 2021-05-10]
CAD/FilimentSupportBracket.SLDPRT
25.4 x 95.9 x 38.1 mm
