VidetteMakes/ValpoFilamentRecycler09/CAD/PCB Boxes/Controller_box.SLDPRT

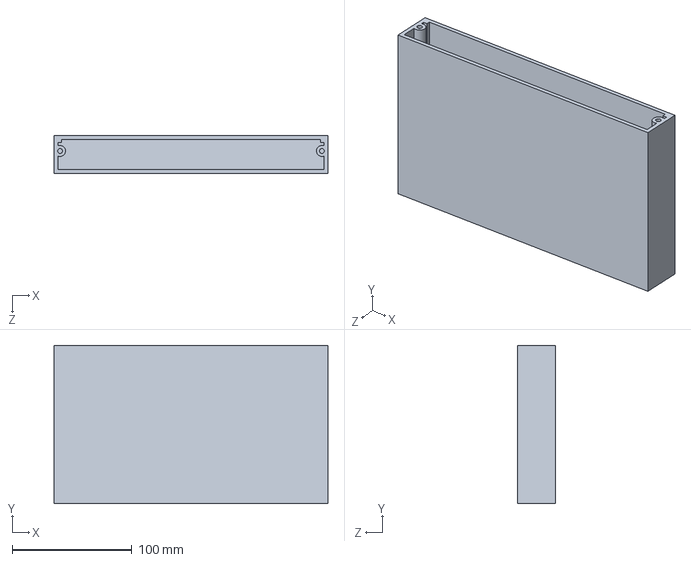
[picture p108: CAD file, 2021-05-10]
CAD/PCB Boxes/Controller_box.SLDPRT
228.6 x 132.1 x 31.8 mm
