VidetteMakes/ValpoFilamentRecycler09/CAD/Spooler/Spooler servo.SLDPRT

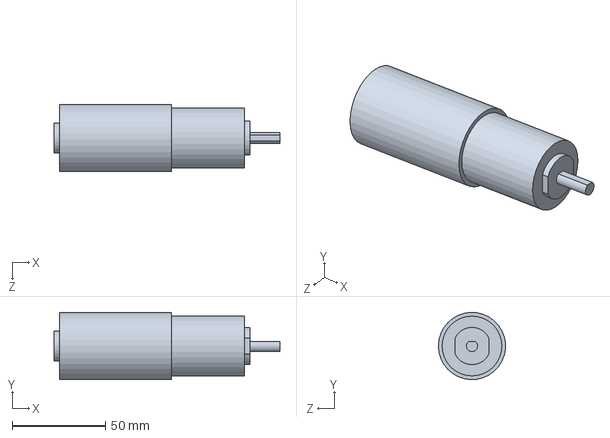
[picture p109: CAD file, 2021-05-10]
CAD/Spooler/Spooler servo.SLDPRT
121.0 x 36.0 x 36.0 mm
