VidetteMakes/ValpoFilamentRecycler09/CAD/Tensioner/ServoF.SLDPRT

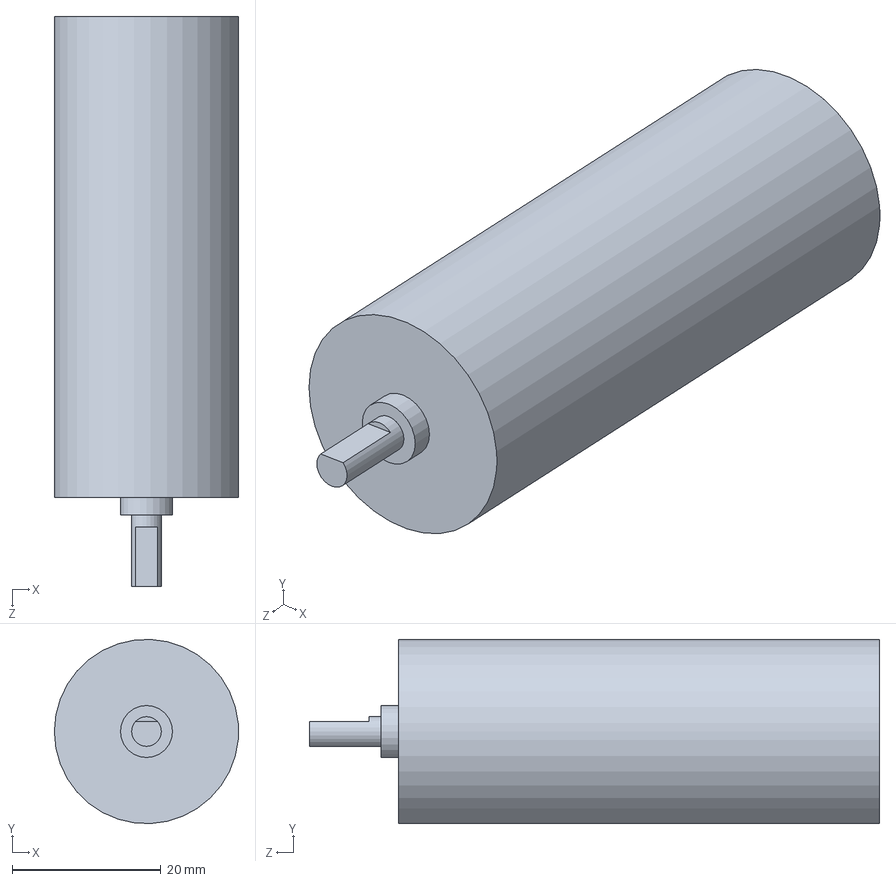
[picture p110: CAD file, 2021-05-10]
CAD/Tensioner/ServoF.SLDPRT
24.8 x 24.8 x 76.7 mm
