VidetteMakes/ValpoFilamentRecycler09/CAD/Troubled components/nikki mods/Roller_AxelF (1).SLDPRT

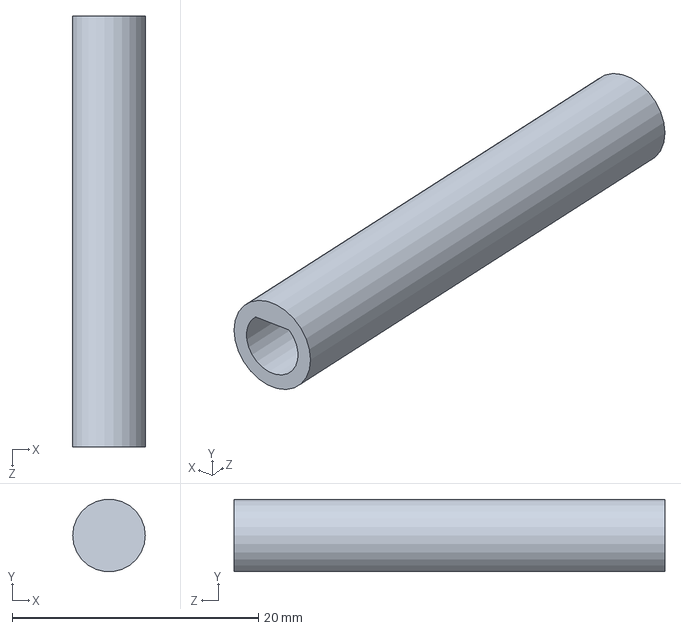
[picture p111: CAD file, 2021-05-10]
CAD/Troubled components/nikki mods/Roller_AxelF (1).SLDPRT
5.90 x 5.86 x 35.0 mm
