VidetteMakes/ValpoFilamentRecycler09/CAD/Dial Indicator Housing/Dial Indicator Housing.SLDPRT

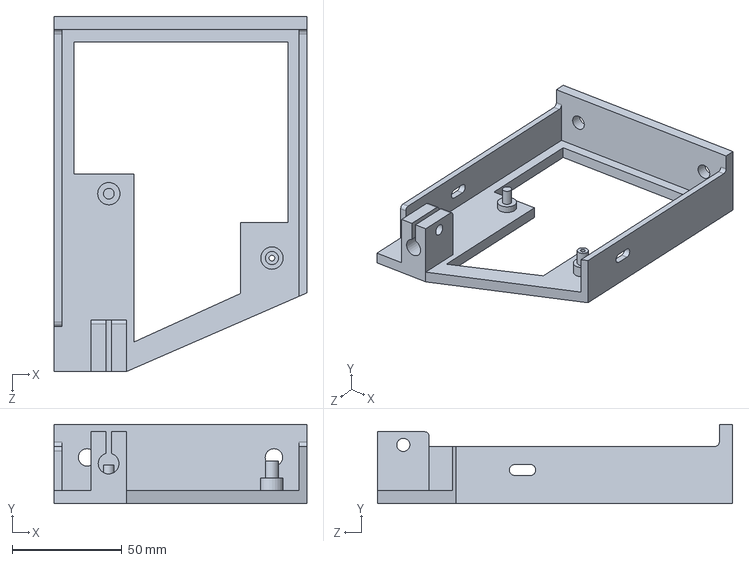
[picture p112: CAD file, 2021-05-10]
CAD/Dial Indicator Housing/Dial Indicator Housing.SLDPRT
115.0 x 36.0 x 161.5 mm
