VidetteMakes/ValpoFilamentRecycler09/CAD/Main components/Hopper.SLDPRT

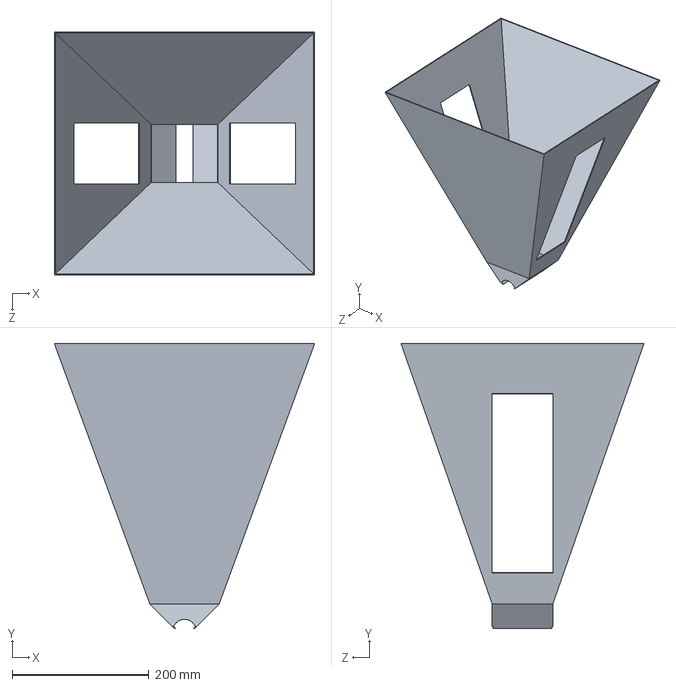
[picture p113: CAD file, 2021-05-10]
CAD/Main components/Hopper.SLDPRT
381.0 x 417.0 x 355.6 mm
