VidetteMakes/ValpoFilamentRecycler09/CAD/Nozzle_3mm (1).SLDPRT

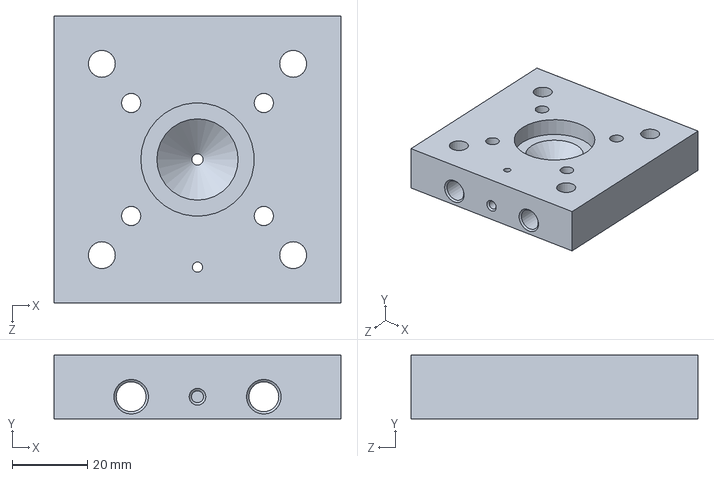
[picture p114: CAD file, 2021-05-10]
CAD/Nozzle_3mm (1).SLDPRT
76.2 x 16.9 x 76.2 mm
