VidetteMakes/ValpoFilamentRecycler09/CAD/Spooler/Mounting body.SLDPRT

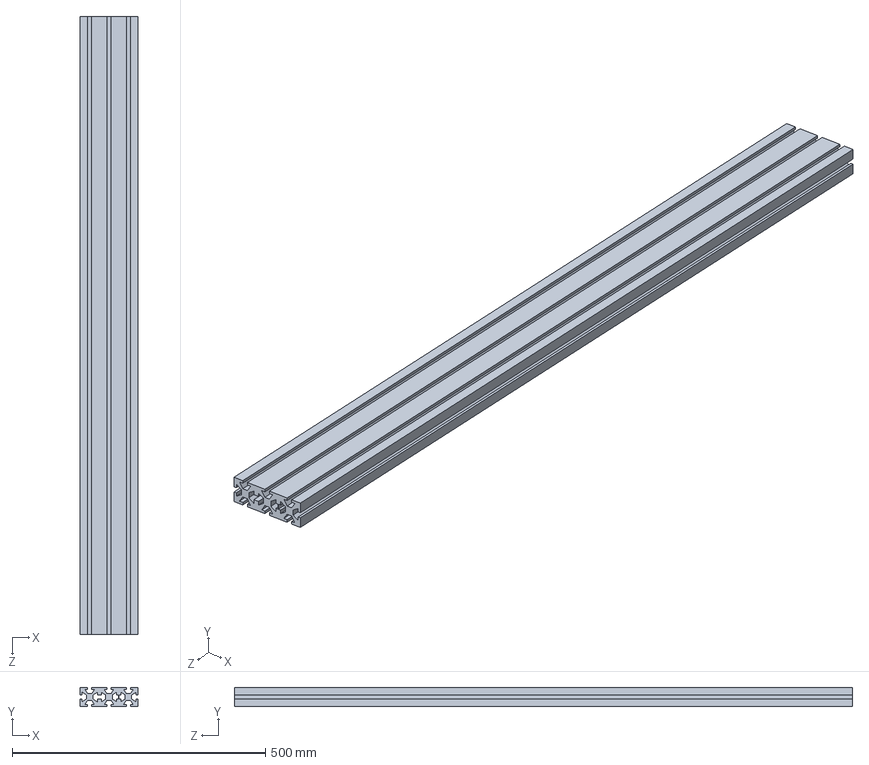
[picture p115: CAD file, 2021-05-10]
CAD/Spooler/Mounting body.SLDPRT
114.3 x 38.1 x 1219.2 mm
