VidetteMakes/ValpoFilamentRecycler09/CAD/Tensioner/RollerF.SLDPRT

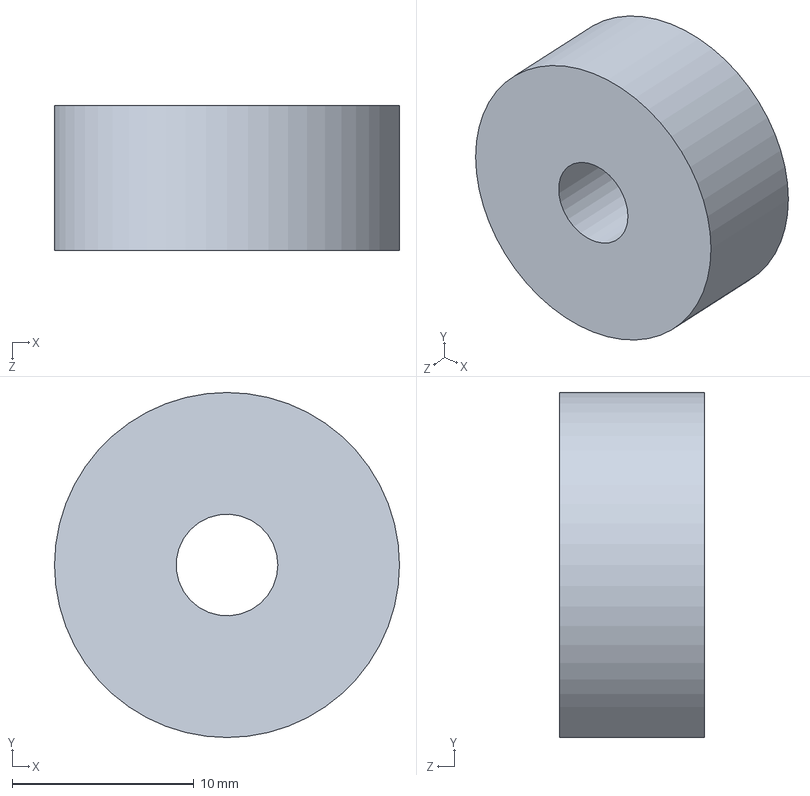
[picture p116: CAD file, 2021-05-10]
CAD/Tensioner/RollerF.SLDPRT
19.0 x 19.0 x 8.00 mm
