VidetteMakes/ValpoFilamentRecycler09/CAD/PCB Boxes/UI_PCB.SLDPRT

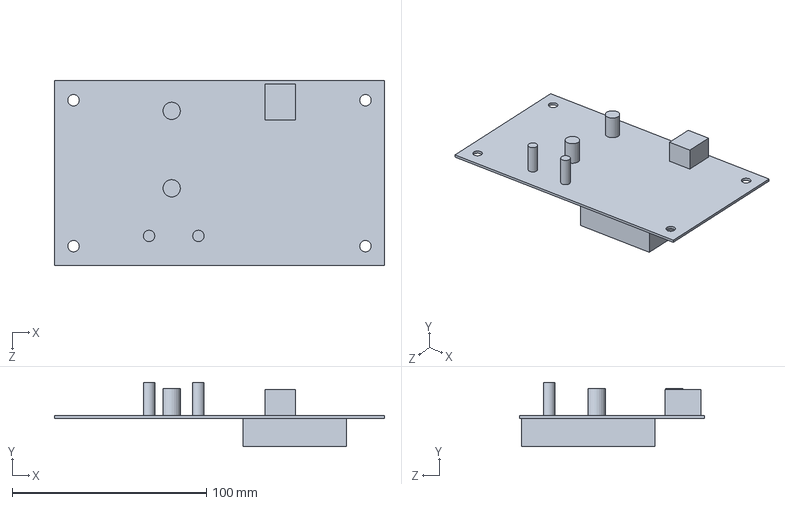
[picture p117: CAD file, 2021-05-10]
CAD/PCB Boxes/UI_PCB.SLDPRT
169.9 x 33.2 x 95.2 mm
