VidetteMakes/ValpoFilamentRecycler09/CAD/Spooler/SpoolCoupler_Adaptor.SLDPRT

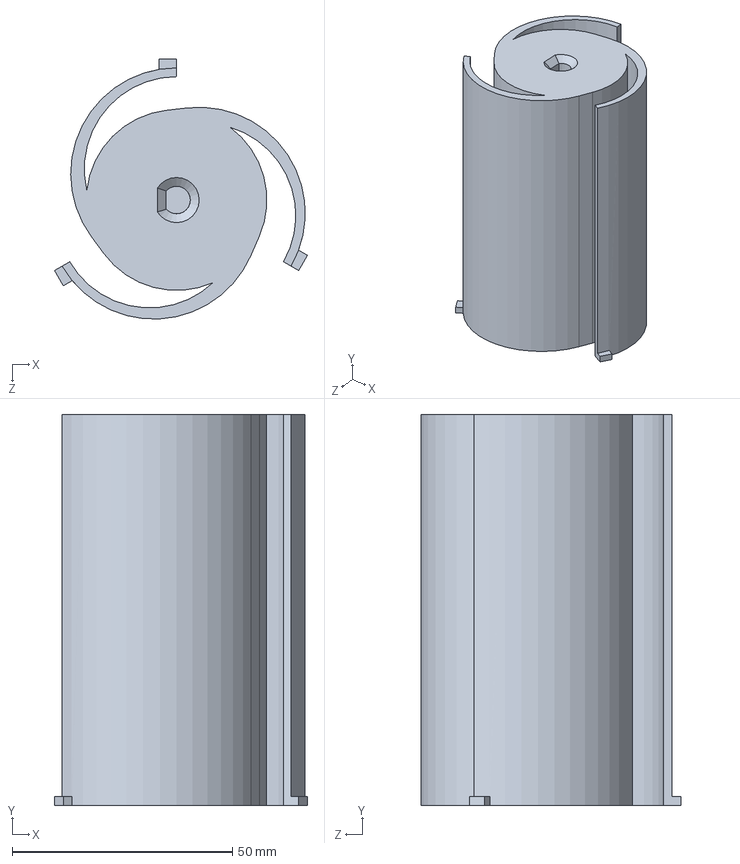
[picture p118: CAD file, 2021-05-10]
CAD/Spooler/SpoolCoupler_Adaptor.SLDPRT
57.4 x 88.7 x 59.0 mm
