VidetteMakes/ValpoFilamentRecycler09/CAD/Main components/Angle IronsF.SLDPRT

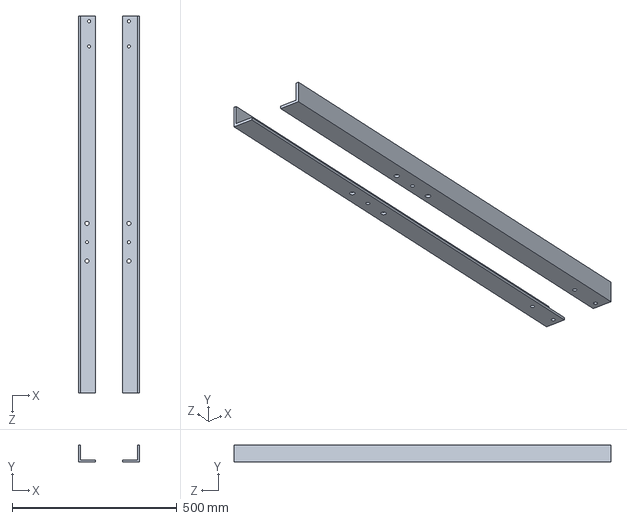
[picture p120: CAD file, 2021-05-10]
CAD/Main components/Angle IronsF.SLDPRT
184.1 x 50.8 x 1143.0 mm
