VidetteMakes/ValpoFilamentRecycler09/CAD/PCB Boxes/UI_Box_Top.SLDPRT

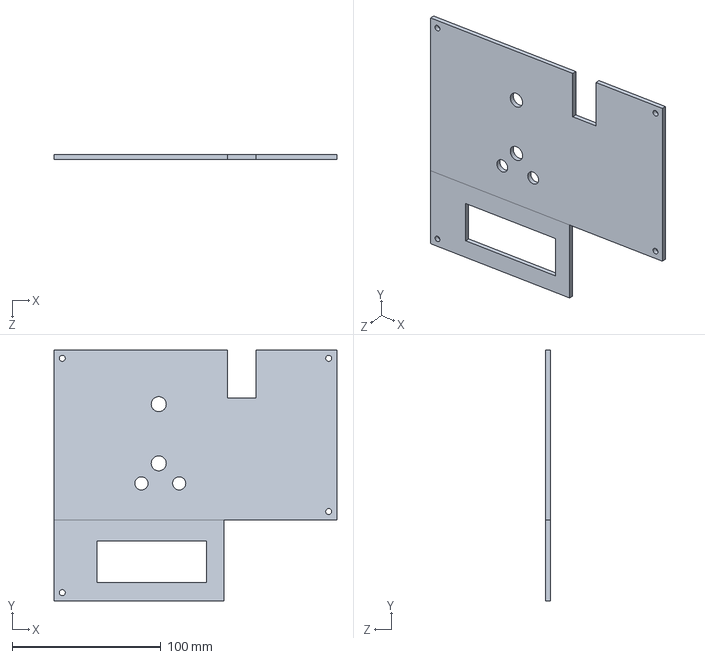
[picture p121: CAD file, 2021-05-10]
CAD/PCB Boxes/UI_Box_Top.SLDPRT
190.5 x 168.9 x 3.17 mm
