VidetteMakes/ValpoFilamentRecycler09/CAD/Spooler/SpoolCrusherEnd.SLDPRT

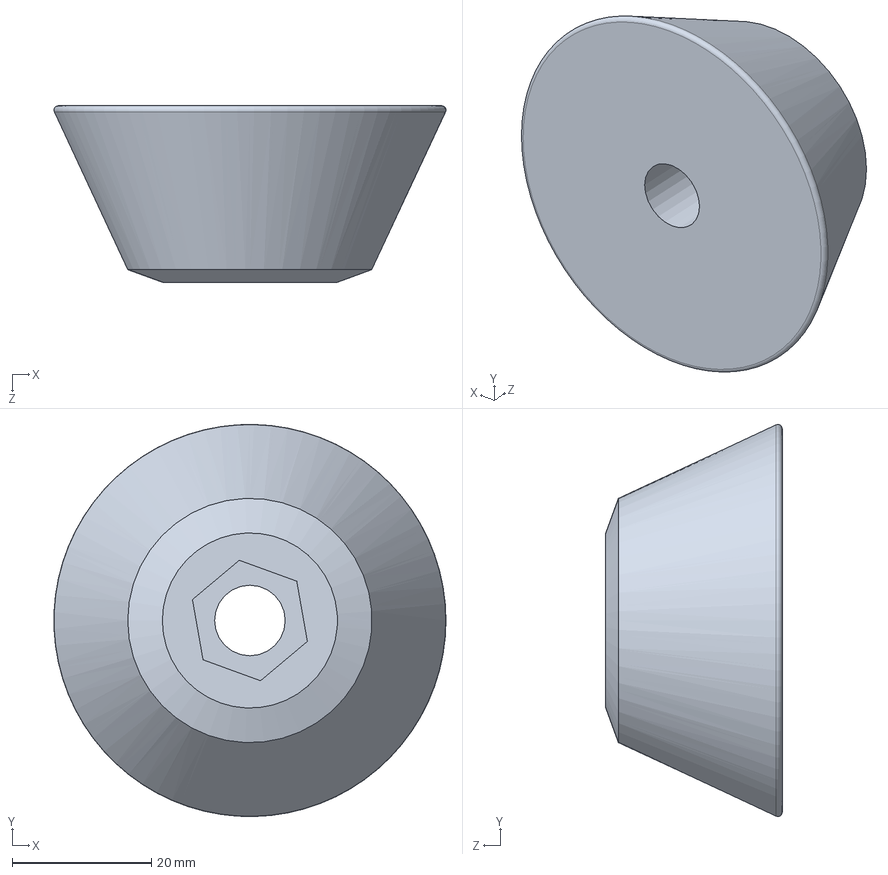
[picture p122: CAD file, 2021-05-10]
CAD/Spooler/SpoolCrusherEnd.SLDPRT
56.4 x 56.4 x 25.4 mm
