VidetteMakes/ValpoFilamentRecycler09/CAD/Tensioner/Roller3.SLDPRT

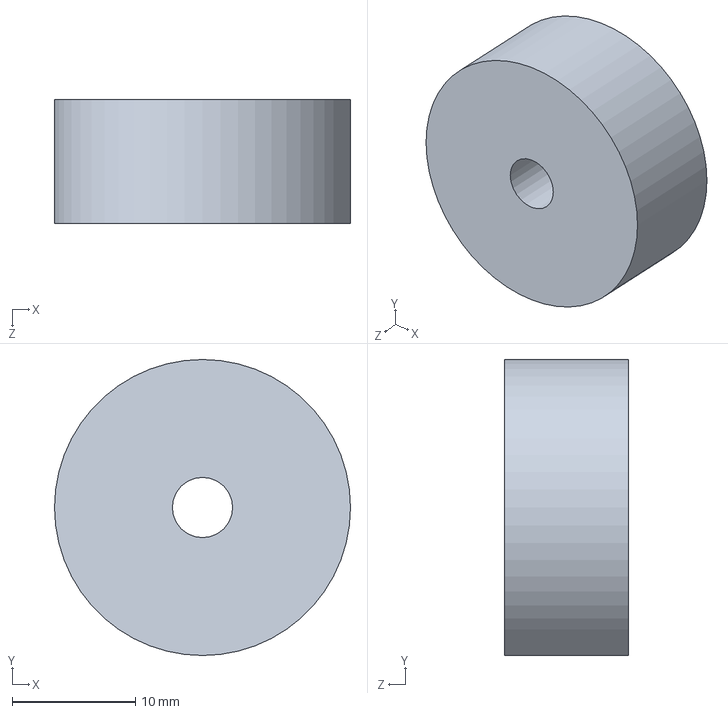
[picture p123: CAD file, 2021-05-10]
CAD/Tensioner/Roller3.SLDPRT
24.0 x 24.0 x 10.1 mm
