VidetteMakes/ValpoFilamentRecycler09/CAD/Tensioner/Roller_AxelF.SLDPRT

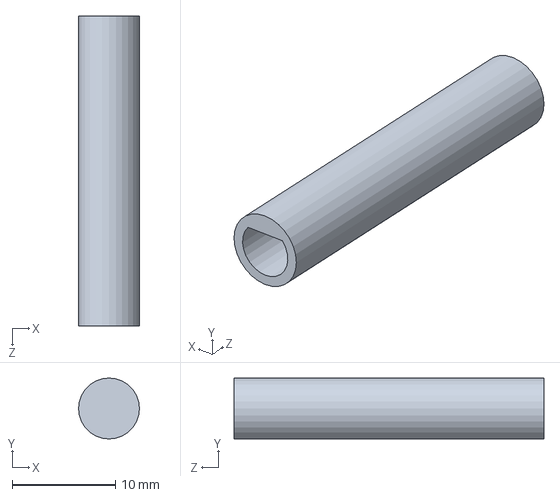
[picture p124: CAD file, 2021-05-10]
CAD/Tensioner/Roller_AxelF.SLDPRT
5.90 x 5.90 x 30.0 mm
