VidetteMakes/ValpoFilamentRecycler09/CAD/Main components/flange.SLDPRT

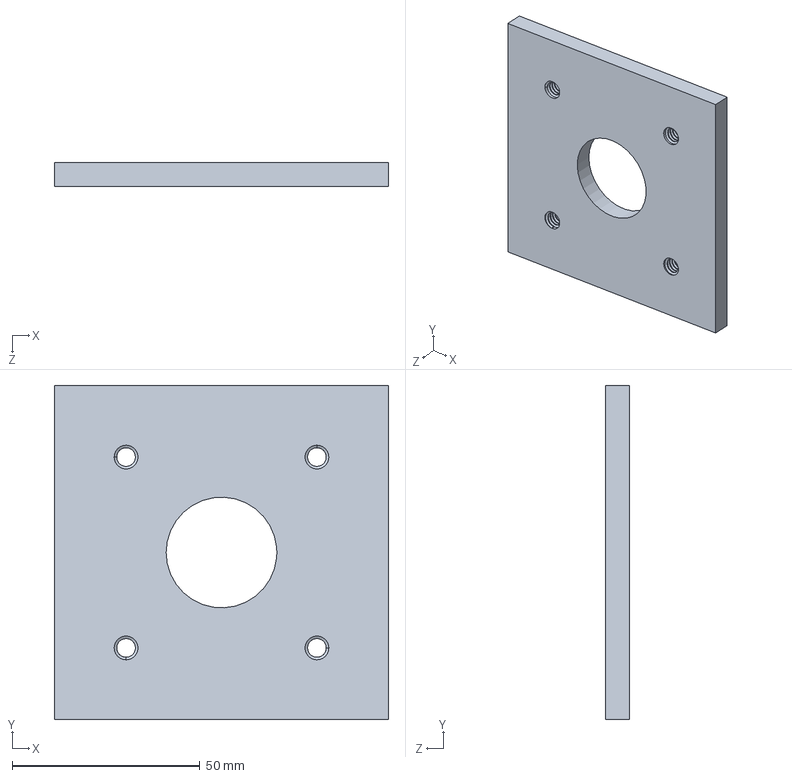
[picture p125: CAD file, 2021-05-10]
CAD/Main components/flange.SLDPRT
88.9 x 88.9 x 6.35 mm
