VidetteMakes/ValpoFilamentRecycler09/CAD/Spooler/BaseMountingPlateSpooler.SLDPRT

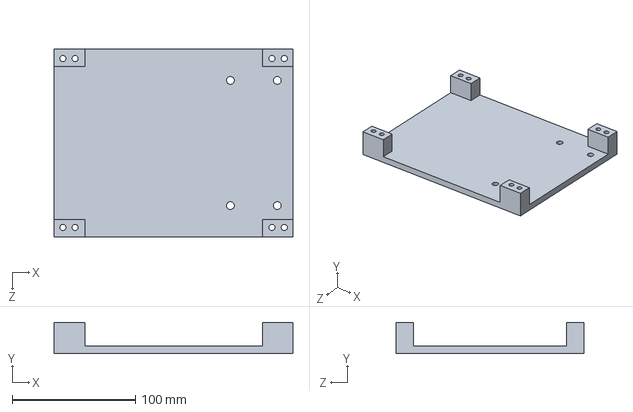
[picture p126: CAD file, 2021-05-10]
CAD/Spooler/BaseMountingPlateSpooler.SLDPRT
194.1 x 25.4 x 152.4 mm
