VidetteMakes/ValpoFilamentRecycler09/CAD/Main components/nozzle cap.SLDPRT

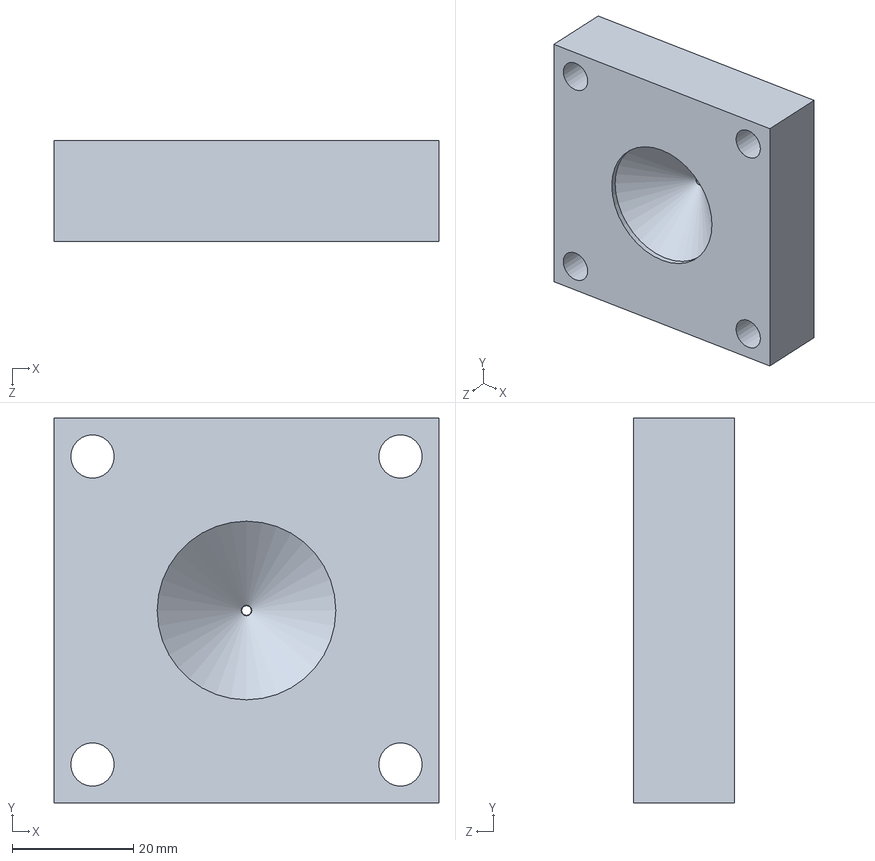
[picture p127: CAD file, 2021-05-10]
CAD/Main components/nozzle cap.SLDPRT
63.5 x 63.5 x 16.7 mm
