VidetteMakes/ValpoFilamentRecycler09/CAD/Spooler/TopPlateSpooler.SLDPRT

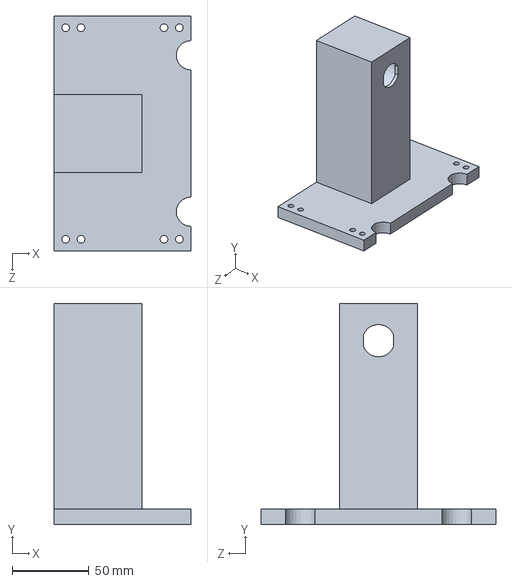
[picture p128: CAD file, 2021-05-10]
CAD/Spooler/TopPlateSpooler.SLDPRT
88.9 x 143.5 x 152.4 mm
