VidetteMakes/ValpoFilamentRecycler09/CAD/Spooler/StrainGauge.SLDPRT

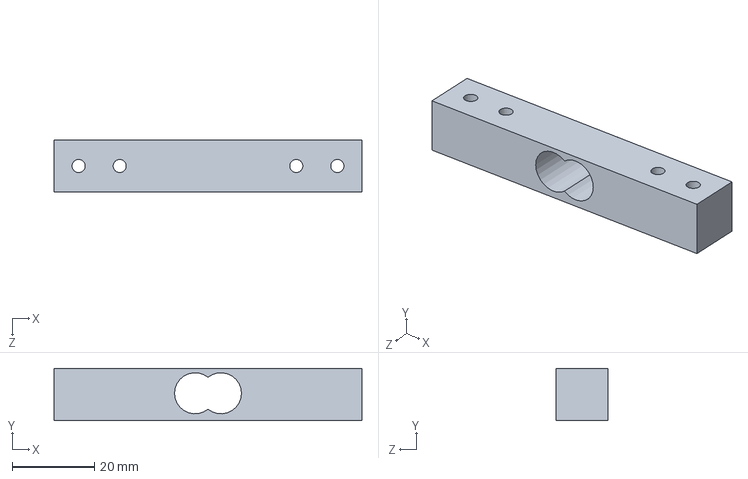
[picture p129: CAD file, 2021-05-10]
CAD/Spooler/StrainGauge.SLDPRT
75.0 x 12.7 x 12.7 mm
