VidetteMakes/ValpoFilamentRecycler09/CAD/Extrusion Assembly/DCMotor.SLDPRT

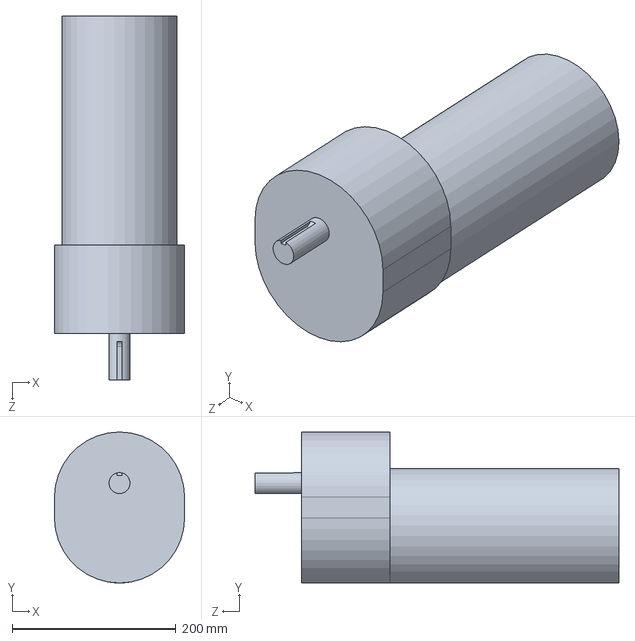
[picture p130: CAD file, 2021-05-10]
CAD/Extrusion Assembly/DCMotor.SLDPRT
158.8 x 184.2 x 443.8 mm
