VidetteMakes/ValpoFilamentRecycler09/CAD/Extrusion Assembly/Front Plate.SLDPRT

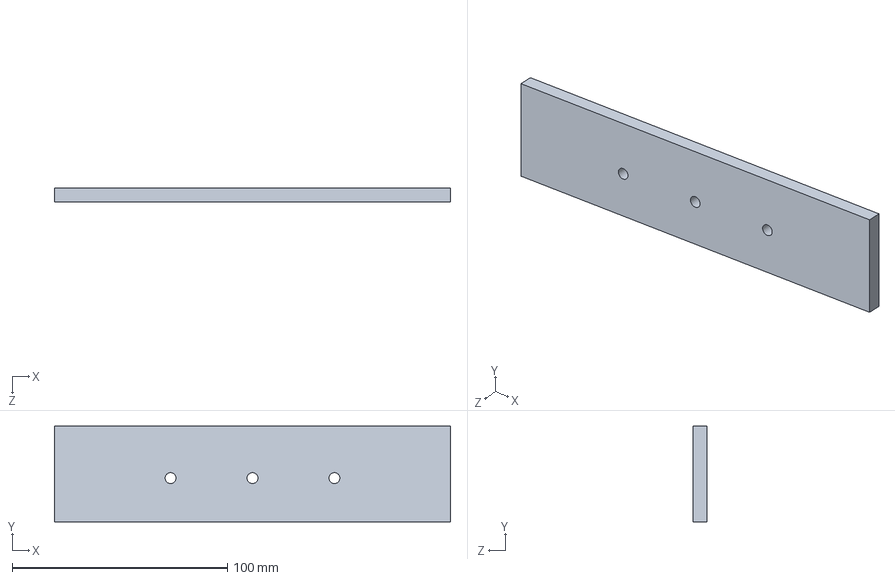
[picture p131: CAD file, 2021-05-10]
CAD/Extrusion Assembly/Front Plate.SLDPRT
184.1 x 44.5 x 6.35 mm
