VidetteMakes/ValpoFilamentRecycler09/(list of files, cad)

Other CAD files:
CAD/Extrusion Assembly/couplerassembly.SLDASM
CAD/Troubled components/nikki mods/Axle4.STL
CAD/Main components/Mounting.SLDPRT
CAD/.STL files/Roller Structure5.STL
CAD/.STL files/RollerF.STL
CAD/Main components/SlackSensorGrande.SLDPRT
CAD/Extrusion Assembly/Mounting.SLDPRT
CAD/Tensioner/Tensioner_Platform.SLDPRT
CAD/Main components/Fan mount 2.0.SLDPRT
CAD/Extrusion Assembly/Angle IronsF.SLDPRT
CAD/.STL files/ServoCap.STL
CAD/Coupler/couplerassembly.SLDDRW
CAD/Dial Indicator Housing/Dial Indicator Housing(1).SLDPRT
CAD/Dial Indicator Housing/Dial Indicator Housing(1).STL
CAD/Dial Indicator Housing/Dial Indicator Housing.STL
CAD/Dial Indicator Housing/FilamentMeasBackPlateV2.ipt
CAD/Dial Indicator Housing/FilamentMeasBackPlateV2.stl
CAD/Dial Indicator Housing/FilamentMeasurementArrmOuterV3.ipt
CAD/Dial Indicator Housing/FilamentMeasurementArrmOuterV3.stl
CAD/Extrusion Assembly/Mounting (1).SLDPRT
CAD/Extrusion Assembly/Screw.SLDPRT
CAD/Main components/Screw.SLDPRT
CAD/PCB Boxes/UI_Box.STL
CAD/PCB Boxes/UI_Box_Top.STL
CAD/Triangular Mounting/Mounting.SLDDRW
CAD/Troubled components/RollerF.SLDPRT
CAD/Troubled components/Roller_AxelF.SLDPRT
CAD/Troubled components/nikki mods/RollerF.STL
CAD/Troubled components/nikki mods/Roller_AxelF (1).STL
