VidetteMakes/ValpoFilamentRecycler09/Documentation from 2020-2021/FMEA.xlsx

XXXXXX CORPORATION
DESIGN FAILURE MODE AND EFFECTS ANALYSIS (DFMEA)
ITEM/SYSTEM NAME : |  | Filament Extruder |  |  | PROCESS RESPONSIBILITY : |  | FUEL TRANSFER PUMP DIVISION |  |  |  | KEY (PPAP) DATE : |  | 2007-10-18
ASSEMBLY P/N : |  | 12345678 |  |  | PREPARED BY : |  |  |  |  |  | ORIGINAL FMEA DATE : |  | 2007-02-13
YEAR/MODEL: |  |  |  |  |  |  |  |  |  |  | REVISION FMEA DATE(S) :
CORE TEAM :
ITEM/ FUNCTION | POTENTIAL FAILURE MODE | POTENTIAL EFFECTS OF FAILURE | S E V | C L A S S | POTENTIAL CAUSES OF FAILURE | O C C U R | EXISTING CONDITIONS |  |  |  | RECOMMENDED ACTIONS | RESPONSIBILITY AND TARGET COMPLETION DATE | ACTION RESULTS
 |  |  |  |  |  |  | CURRENT CONTROLS |  | D E T E C | R. P. N. |  |  | ACTIONS TAKEN | S E V | O C C U R | D E T E C | R. P. N.
 |  |  |  |  |  |  | PREVENTION | DETECTION
Heater | Barrel doesnt get to desired temperature | Filament gets too liquidy |  |  | faulty heater
 |  | filament doesnt extrude |  |  | wrong thermocouple readings
 | Barrel does not maintain temperature | filament does not extrude |  |  | faulty heater
 |  | filament extrudes out of tolerance |  |  | bad temperature controller
Motor
 |  |  |  |  | Connor |  | Alec | Oscar |  |  | Nikki | Jon | Munib
 |  |  |  |  |  |  |  |  |  |  |  | Short circuit
 |  |  |  |  |  |  |  |  |  |  |  | Fire
 |  |  |  |  |  |  |  |  |  |  |  |  | Coupling breaks
 |  |  |  |  |  |  |  |  |  |  |  | UI breaks
 |  |  |  |  | system doesnt shut off properly |  | Support structure failure
 |  |  |  |  |  |  |  |  |  |  |  |  | Misalignment due to pushing ground up through mesh
 |  |  |  |  |  |  | Spooling | Extrusion |  |  | Heating | Motor | Sensors
 |  |  |  |  |  |  | filament isnt spooled properly | Doesnt extrude |  |  | Barrel too hot | Motor heating up | Micrometer breaks down
 |  |  |  |  |  |  | Spooler going too fast | gets clogged |  |  | Barrel not heating | Motor isnt fast enough | bad sensor reading
 |  |  |  |  |  |  | Roller/spooler break down | Screw Doesnt spin |  |  |  |  | Temp probes misreading
 |  |  |  |  |  |  | Scale stops working | Filament snaps/breaks |  |  | Metal frame heats up |  | feedback loop doesnt work
 |  |  |  |  |  |  |  | Roller deforms filament |  |  | Insulation failure
 |  |  |  |  |  |  |  | Nekhing becuse of tension in axial direction |  |  | Hopper gets hot enough that some filament starts to melt in the hopper
 |  |  |  |  |  |  |  | Filament out of tolerance |  |  | Barrel doesn't hold temp +/- 2.5 C
 |  |  |  |  |  |  |  | Filament not cooling |  |  | Any exposed surface's temp gets above 49 C
