VidetteMakes/ValpoFilamentRecycler09/CAD/Coupler/couplerassemblydrawing.pdf

B | B

2

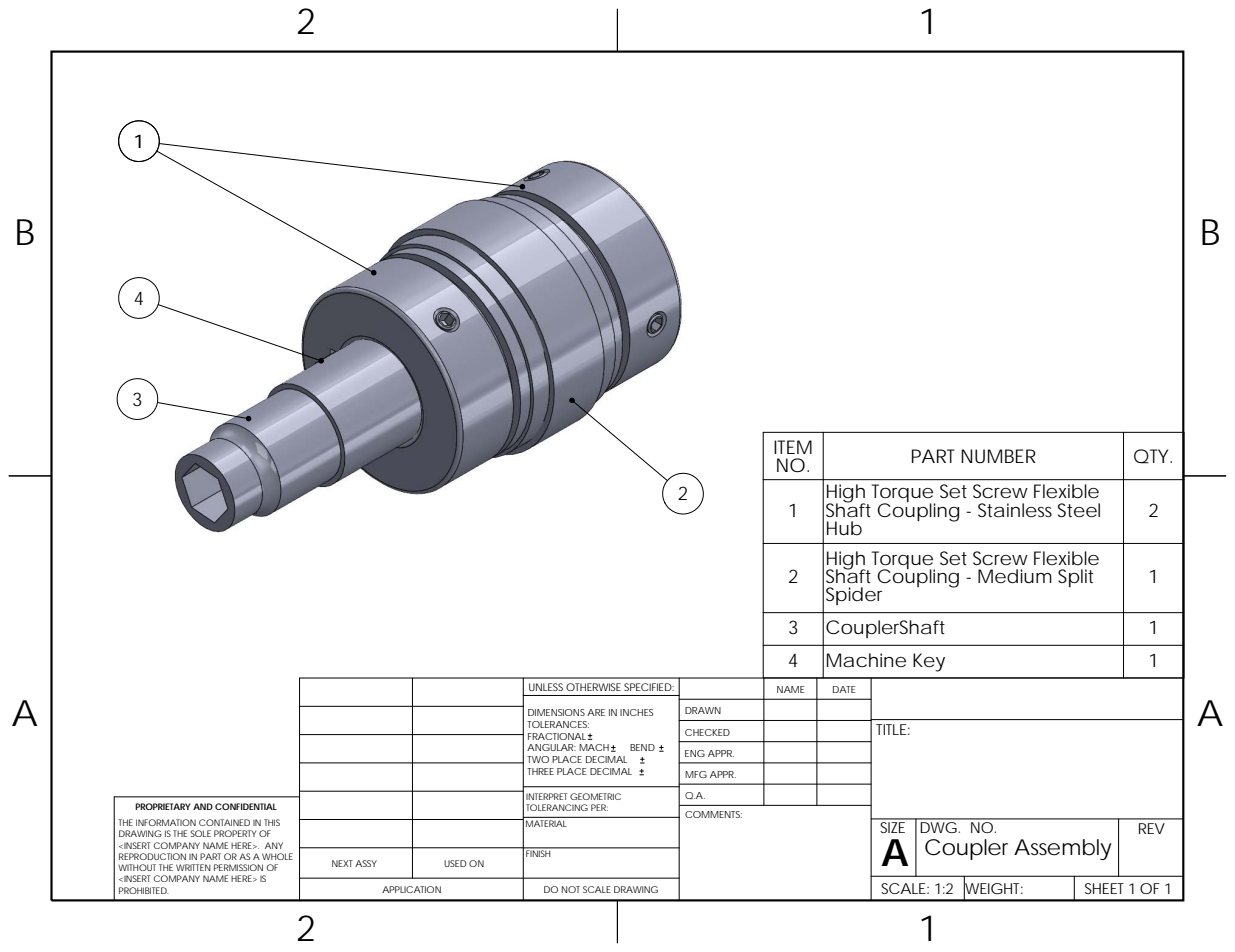
[picture p132: page 1]
SCALE: 1:2; SHEET 1 OF 1; WEIGHT:; REV; TITLE:; COMMENTS:; APPLICATION; PROPRIETARY AND CONFIDENTIAL; TOLERANCING PER:

ITEM NO. | PART NUMBER | QTY.

1 | High Torque Set Screw Flexible Shaft Coupling - Stainless Steel Hub | 2

2 | High Torque Set Screw Flexible Shaft Coupling - Medium Split Spider | 1

3 | CouplerShaft | 1
4 | Machine Key | 1

UNLESS OTHERWISE SPECIFIED: | | NAME | DATE

DIMENSIONS ARE IN INCHES TOLERANCES: FRACTIONAL ANGULAR: MACH BEND TWO PLACE DECIMAL THREE PLACE DECIMAL | DRAWN

CHECKED
ENG APPR.
MFG APPR.

INTERPRET GEOMETRIC | Q.A.
MATERIAL | | SIZE A Coupler Assembly | DWG. NO.

THE INFORMATION CONTAINED IN THIS
DRAWING IS THE SOLE PROPERTY OF
<INSERT COMPANY NAME HERE>. ANY
REPRODUCTION IN PART OR AS A WHOLE
WITHOUT THE WRITTEN PERMISSION OF
<INSERT COMPANY NAME HERE> IS
PROHIBITED.

NEXT ASSY | USED ON | FINISH

DO NOT SCALE DRAWING
