VidetteMakes/ValpoFilamentRecycler09/PCB/Spooler Motor Adaptor/Spooler Motor Adaptor Schematic.pdf

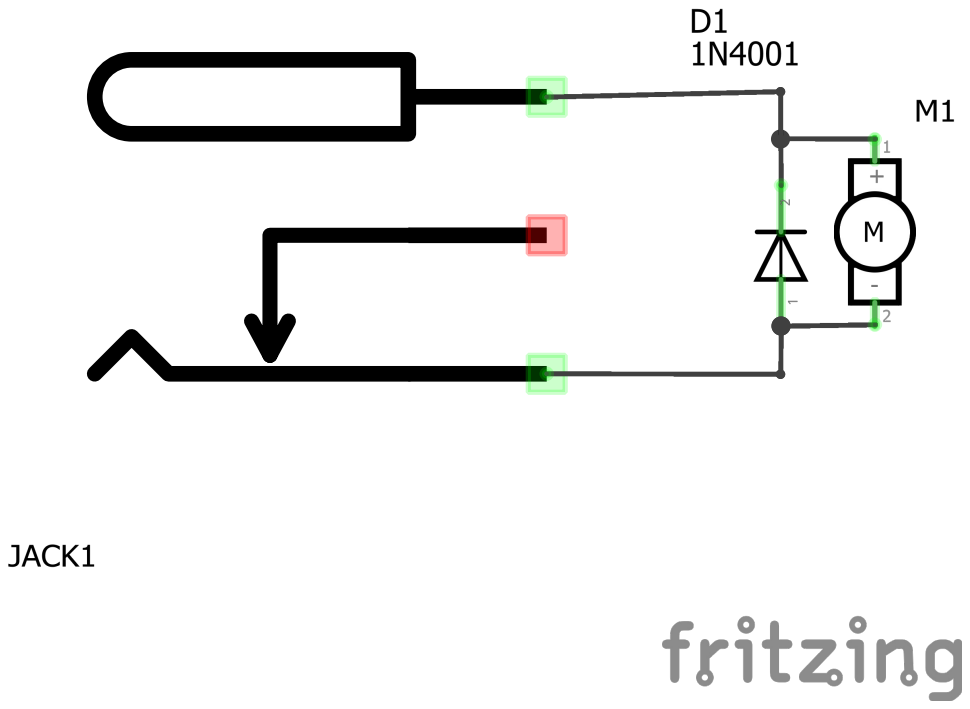
[picture p134: page 1]
