VidetteMakes/ValpoFilamentRecycler09/(list of files, drawings)

Other design files:
PCB/Extruder/Extruder.fzz
PCB/Spooler Controller/Spooler Controller.fzz
PCB/Spooler Motor Adaptor/Spooler Motor Adaptor.fzz
PCB/Spooler Motor Driver/Spooler Motor Driver.fzz
