VidetteMakes/ValpoFilamentRecycler09/PCB/Extruder/Components/MKR_shield_template-master/MKRShield_v1.sch

## KiCad design PCB/Extruder/Components/MKR_shield_template-master/MKRShield_v1.sch (2020-10-18)

Schematic: MKRShield_v1.sch

Parts:
J1, J2: 61301411121
