VidetteMakes/ValpoFilamentRecycler09/(commit log)

2020-10-15 Kicad Added
    [ValpoFilamentExtruderSchematic.sch]
2020-10-16 Schematic Started
    [ValpoFilamentExtruderSchematic.sch]
2020-10-17 Added first version of schematic
    [ValpoFilamentExtruderSchematic.sch]
2020-10-18 Added Stuff
    [MKRShield_v1.kicad_pcb, MKRShield_v1.sch, ValpoFilamentExtruderSchematic.sch]
2021-04-20 Add PCB diagrams
    Added PCB boards for the controller and UI
    [ControllerPCB-B_Cu.gbr, ControllerPCB-B_Mask.gbr, ControllerPCB-B_SilkS.gbr, ControllerPCB-Edge_Cuts.gbr, ControllerPCB-F_Cu.gbr, ControllerPCB-F_Mask.gbr, ControllerPCB-F_SilkS.gbr, ControllerPCB-NPTH.drl]
2021-05-04 Fix Typo in Spooler
    [ControllerPCB.kicad_pcb]
2021-05-10 Added Cad and documentation
    [1kg_Spool.SLDPRT, Angle IronsF.SLDPRT, Axle4.SLDPRT, Axle4.STL, BOM Final.xlsx, Back_plate.SLDPRT, Barrel1.3.SLDPRT, Barrel_Assembly.SLDASM]
2021-06-30 Trying to figure out what parts are in each sheet of the BOM.
    [BOM Final.xlsx]
2021-07-08 Continue updating BOM.
    [BOM Final.xlsx]
2021-07-08 Moving files.
    [1kg_Spool.SLDPRT, Angle IronsF.SLDPRT, Axle4.SLDPRT, Axle4.STL, Back_plate.SLDPRT, Barrel1.3.SLDPRT, Barrel_Assembly.SLDASM, Base.SLDASM]
2021-07-14 Updating BOM; there were some parts that were incorrect vs. what's actually used in the machines.
    [BOM.xlsx]
2021-07-14 Experimenting with Fritzing to create wiring diagrams.
    [Extruder.fzz]
2021-07-14 work on updating BOM.
    [BOM.xlsx]
2021-07-14 Updating BOM.
    [BOM.xlsx]
2021-07-14 Folder rename.
    [1kg_Spool.SLDPRT, Axle4.SLDPRT, BaseMountingPlateSpooler.SLDPRT, Mounting body.SLDPRT, Roller Structure5.SLDPRT, Roller3.SLDPRT, RollerF.SLDPRT, Roller_AxelF.SLDPRT]
2021-07-14 Added a few components.
    [Extruder.fzz]
2021-07-15 Added parts that we need to order to complete the machines.
    [BOM.xlsx]
2021-07-15 Schematic now fits on a letter size page. Output to PDF.
    [ControllerPCB.sch]
2021-07-15 Organized PCB files.
2021-07-15 Updated BOM.
    [BOM.xlsx]
2021-07-16 Added datasheet for power connector.
2021-07-16 Added Fritzing "breadboard" diagram of UI components.
    [UI.fzz]
2021-07-16 Updated Extruder wiring diagram with parts.
    [Extruder.fzz]
2021-07-17 Converted files to open format.
    [FilamentMeasBackPlateV2.stl, FilamentMeasBackPlateV2.stp, FilamentMeasurementArrmOuterV3.stl, FilamentMeasurementArrmOuterV3.stp]
2021-07-20 Made a note of connector type needed.
    [BOM.xlsx]
2021-07-22 Added hand-built circuit for spooler and fan motors.
    [Spooler, Fan Driver.fzz]
2021-07-23 BOM updates.
    [BOM.xlsx]
2021-07-23 BOM much nicer!
    [BOM.xlsx]
2021-07-23 Moved files.
    [Spooler, Fan Driver.fzz]
2021-07-24 Fan driver circuit corrections.
    [Spooler, Fan Driver.fzz]
2021-07-24 Spooler Updates to BOM, Schematic.
    [BOM.xlsx, Spooler, Fan Driver.fzz]
2021-07-25 Added 12V to 5V DC/DC Converter.
    [BOM.xlsx]
2021-07-25 Spooler's fan driver circuit works! At least the right side circuit does. Left side is included in the controller PCB, so I didn't make it on a perfboard.
    [Spooler, Fan Driver.fzz]
2021-08-04 Added adaptor PCB for small DC motor (not finished).
    [Spooler Motor Adaptor.fzz]
2021-08-04 BOM update.
    [BOM.xlsx, UI.fzz]
2021-08-05 Starting to research properties of various plastics.
    [Plastic Temperatures.xlsx]
2022-08-29 Deleting old files that no longer represent the design.
    [UIpcb-B_Cu.gbr, UIpcb-B_Mask.gbr, UIpcb-B_SilkS.gbr, UIpcb-Edge_Cuts.gbr, UIpcb-F_Cu.gbr, UIpcb-F_Mask.gbr, UIpcb-F_SilkS.gbr, UIpcb-NPTH.drl]
2022-08-29 Updated controller PCB.
    [ControllerPCB.sch]
2022-08-29 Updated extruder PCB for latest KiCad version.
    [ValpoFilamentExtruderSchematic.sch]
2022-08-29 Updating schematics for spooling machine.
    [BOM.xlsx, Extruder.fzz, MKRShield_v1.kicad_pcb, MKRShield_v1.sch, Spooler Controller.fzz, Spooler Motor Adaptor.fzz, Spooler Motor Driver.fzz, ValpoFilamentExtruderSchematic.sch]
2022-08-30 Removed potentiometers and Ethernet connector.
    [Spooler Controller.fzz]
2023-03-14 Updated documents for Extruder v2.0. In progress.
    [BOM.xlsx, Spooler Controller.fzz]
2023-03-15 Added enclosure manufacturer info.
    [BOM.xlsx]
2024-01-28 Updating electronics to get closer to 3.0.
    [ControllerPCB-B_Cu.gbr, ControllerPCB-B_Mask.gbr, ControllerPCB-B_SilkS.gbr, ControllerPCB-Edge_Cuts.gbr, ControllerPCB-F_Cu.gbr, ControllerPCB-F_Mask.gbr, ControllerPCB-F_SilkS.gbr, ControllerPCB-NPTH.drl]
2024-01-28 Unsure...it's been a while.
    [BOM.xlsx]
